twfth9/Morg_Grad_Cap/Grad/Hardware/Masters.png

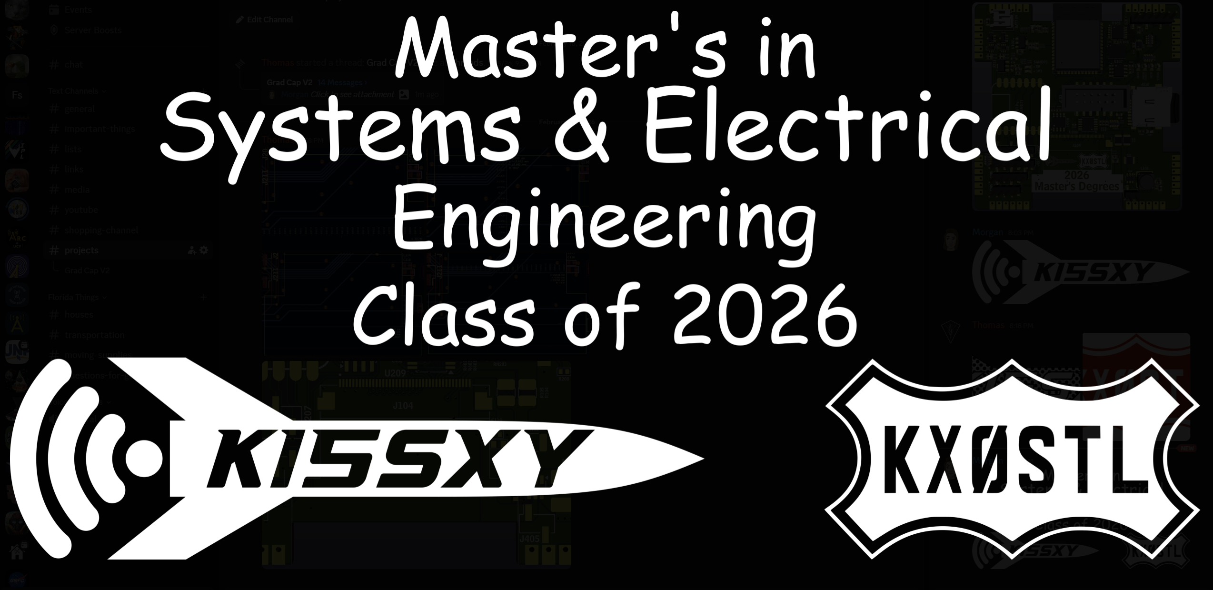
Grad/Hardware/Masters.png
