twfth9/Morg_Grad_Cap/Undergrad/Hardware/Images/morg_grad_cap.png

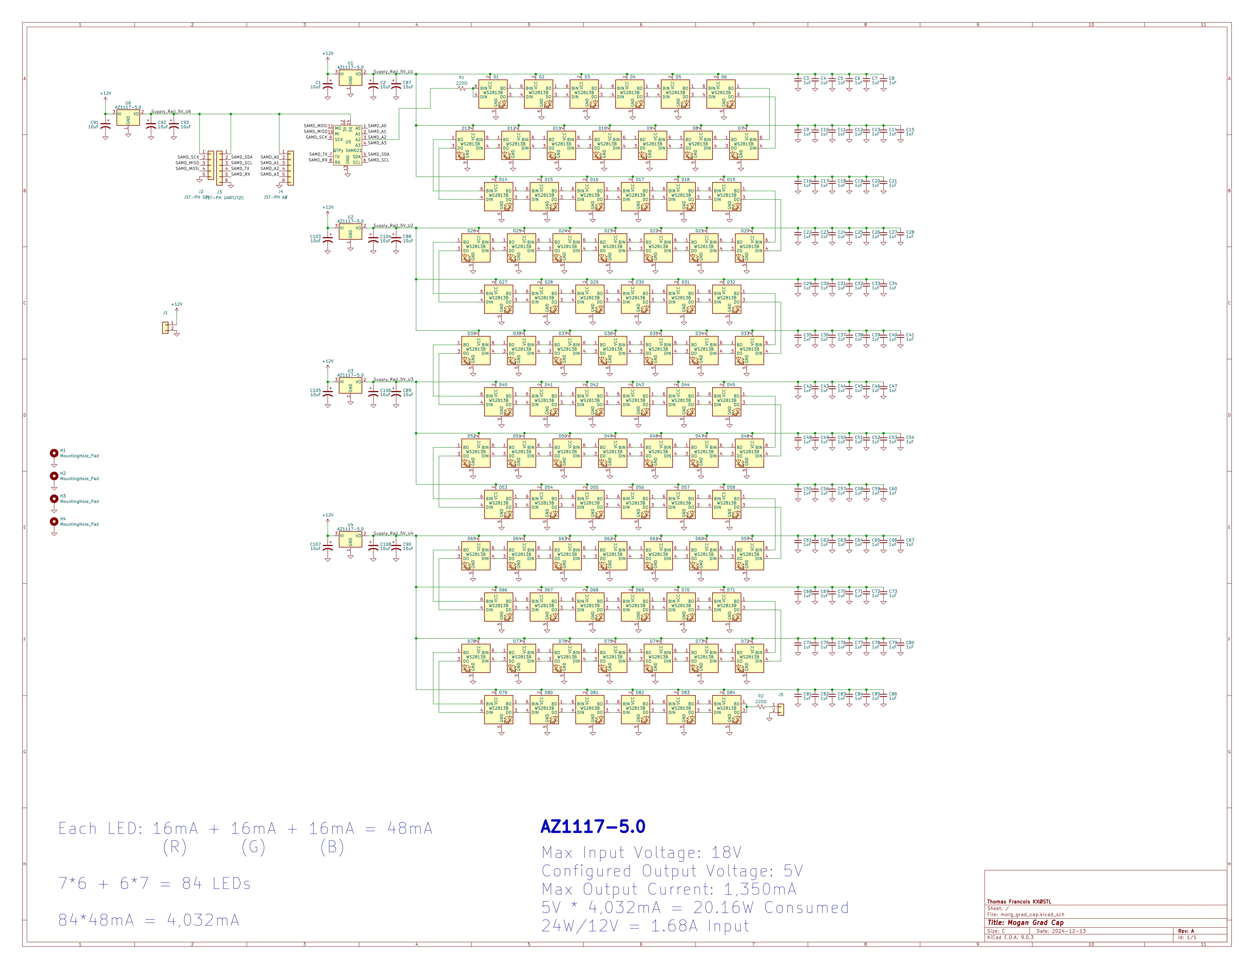
Undergrad/Hardware/Images/morg_grad_cap.png
