twfth9/Morg_Grad_Cap/Undergrad/Hardware/morg_grad_cap.kicad_pcb

## KiCad design Undergrad/Hardware/morg_grad_cap.kicad_pcb (2024-10-15)

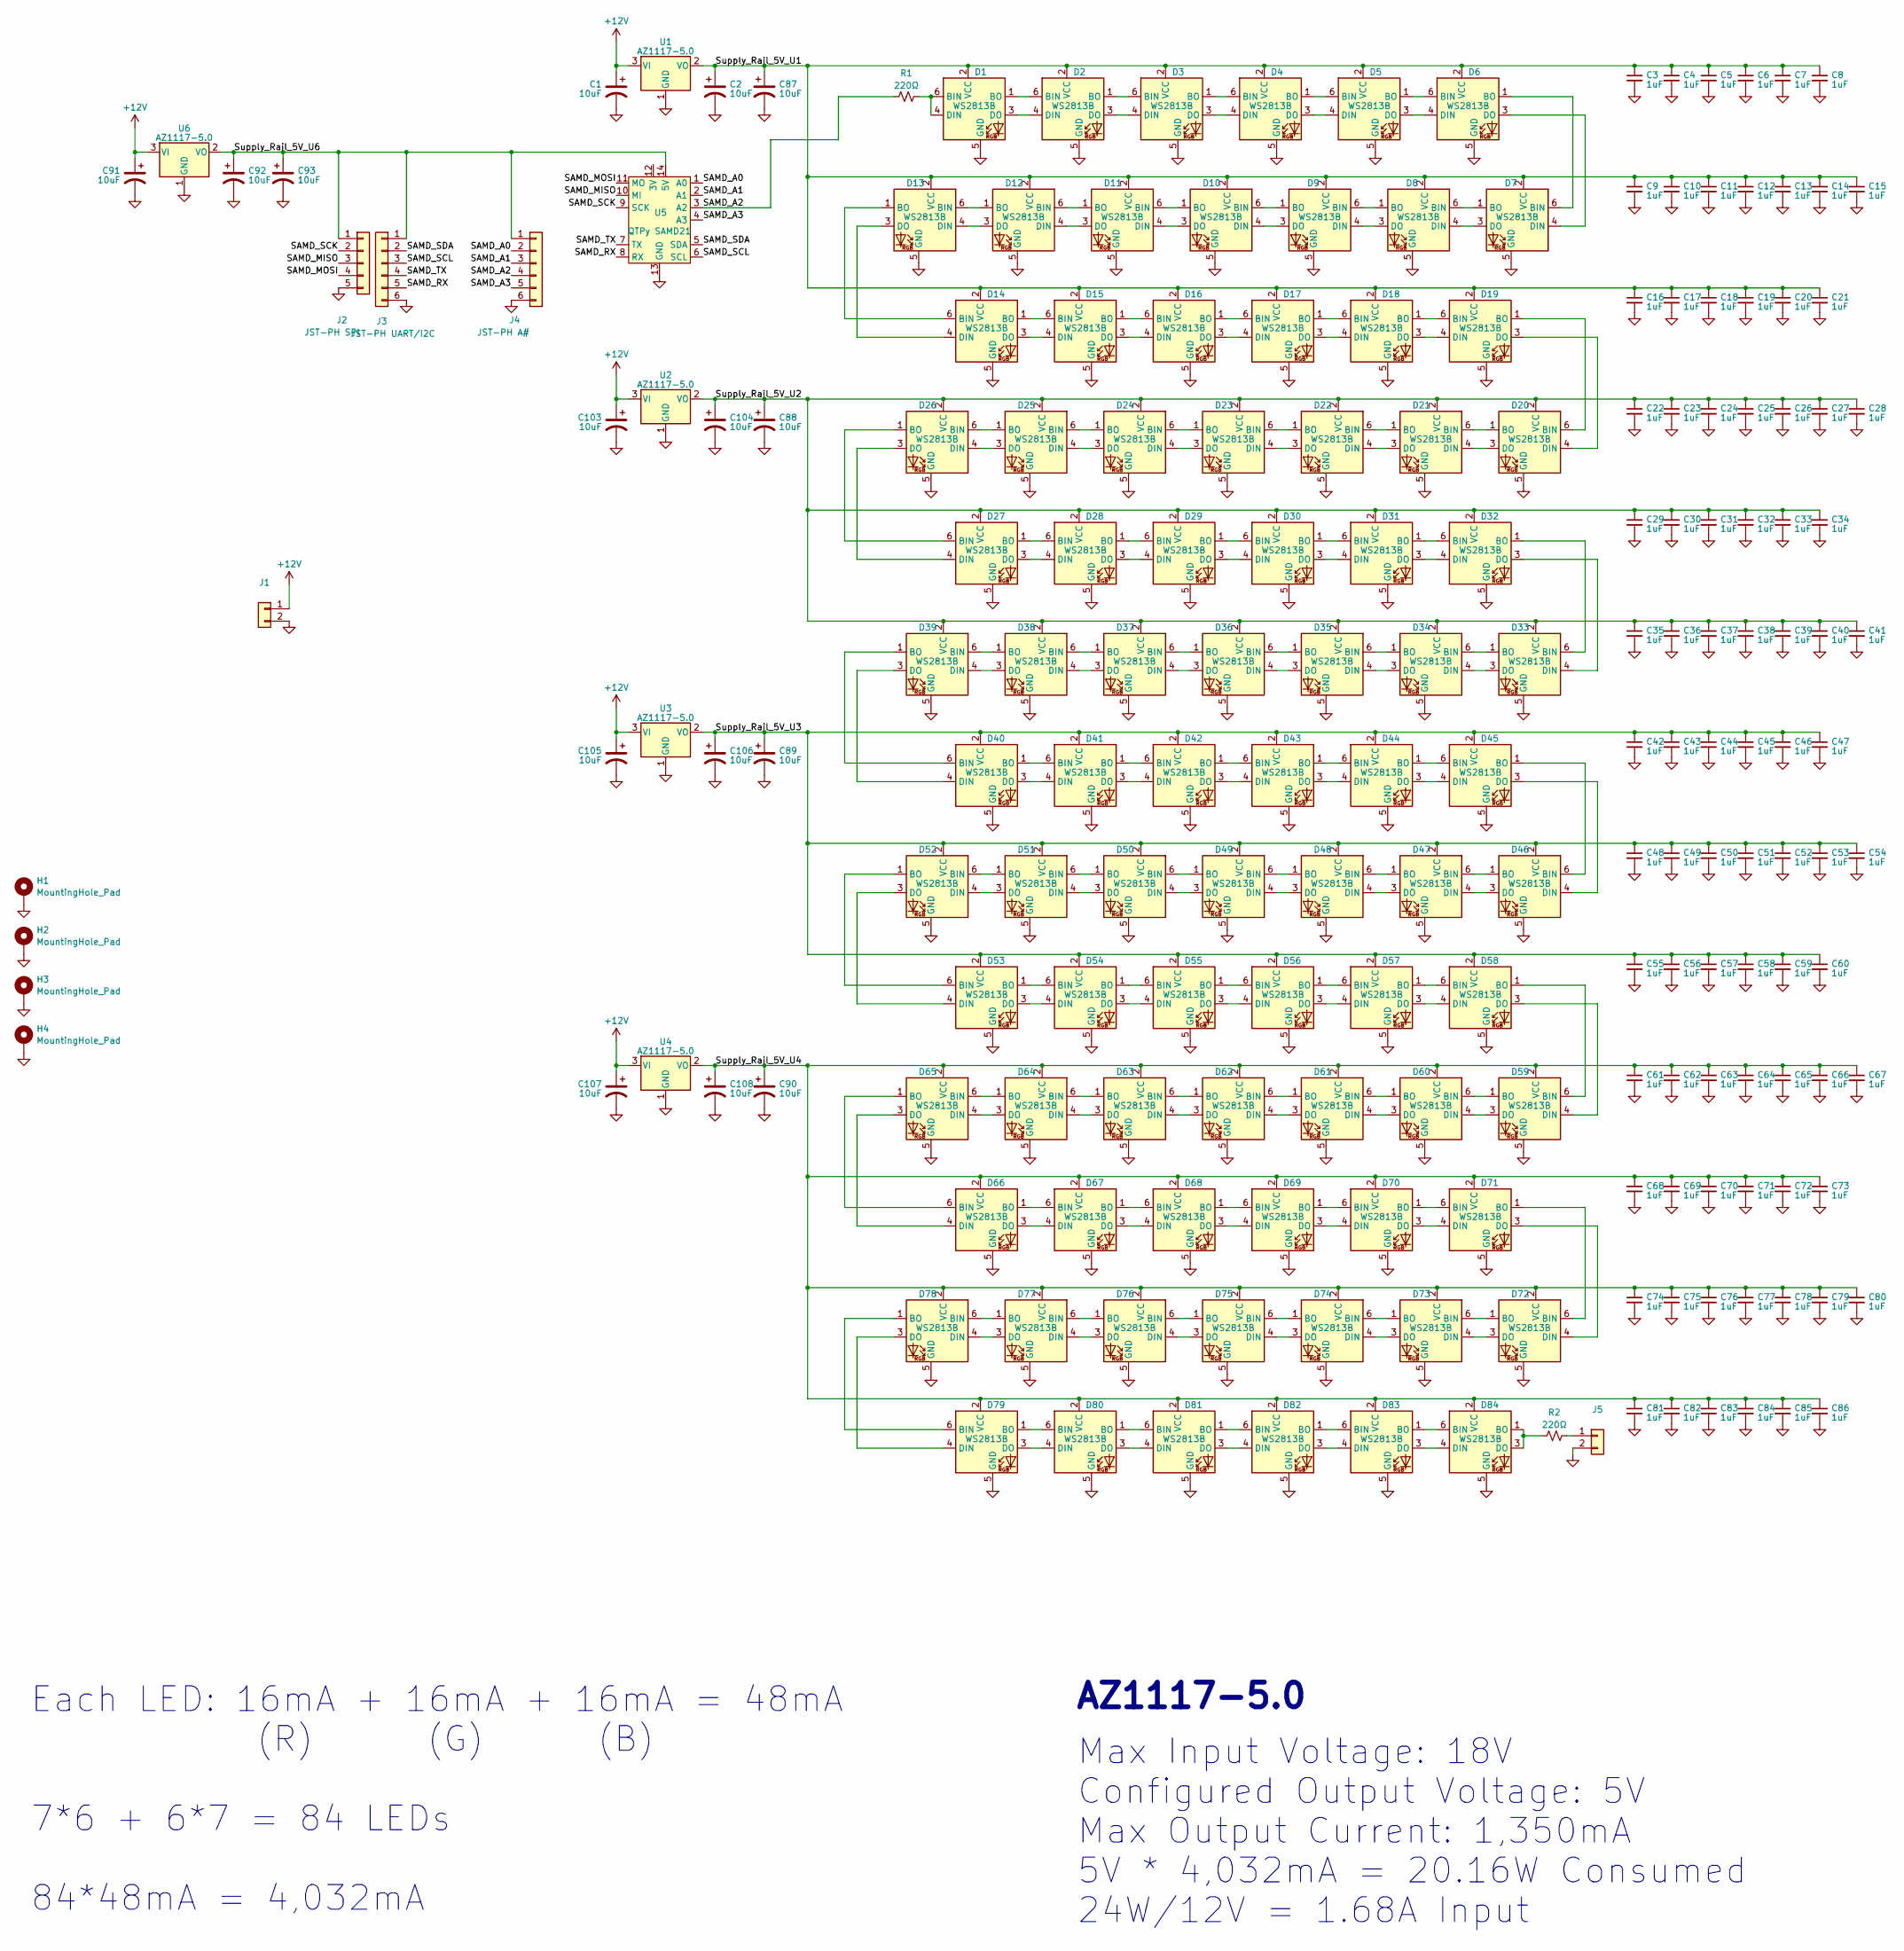
[picture p4: schematic morg_grad_cap.kicad_sch, Mogan Grad Cap]

Parts:
C1, C2, C87, C88, C89, C90, C91, C92, C93, C103, C104, C105, C106, C107, C108: 10uF; C_0805_2012Metric_Pad1.18x1.45mm_HandSolder
C3, C4, C5, C6, C7, C8, C9, C10, C11, C12, C13, C14, C15, C16, C17, C18, C19, C20, C21, C22, C23, C24, C25, C26, C27, C28, C29, C30, C31, C32, C33, C34, C35, C36, C37, C38, C39, C40, C41, C42, C43, C44, C45, C46, C47, C48, C49, C50, C51, C52, C53, C54, C55, C56, C57, C58, C59, C60, C61, C62, C63, C64, C65, C66, C67, C68, C69, C70, C71, C72, C73, C74, C75, C76, C77, C78, C79, C80, C81, C82, C83, C84, C85, C86: 1uF; C_0603_1608Metric_Pad1.08x0.95mm_HandSolder
D1, D2, D3, D4, D5, D6, D7, D8, D9, D10, D11, D12, D13, D14, D15, D16, D17, D18, D19, D20, D21, D22, D23, D24, D25, D26, D27, D28, D29, D30, D31, D32, D33, D34, D35, D36, D37, D38, D39, D40, D41, D42, D43, D44, D45, D46, D47, D48, D49, D50, D51, D52, D53, D54, D55, D56, D57, D58, D59, D60, D61, D62, D63, D64, D65, D66, D67, D68, D69, D70, D71, D72, D73, D74, D75, D76, D77, D78, D79, D80, D81, D82, D83, D84: WS2813B; LED_WS2812_PLCC6_5.0x5.0mm_P1.6mm
H1, H2, H3, H4: MountingHole_Pad; MountingHole_3.2mm_M3_Pad
J1: JST-PH Batt Power In; JST_PH_S2B-PH-K_1x02_P2.00mm_Horizontal
J2: JST-PH SPI; JST_PH_S5B-PH-K_1x05_P2.00mm_Horizontal
J3: JST-PH UART/I2C; JST_PH_S6B-PH-K_1x06_P2.00mm_Horizontal
J4: JST-PH A#; JST_PH_S6B-PH-K_1x06_P2.00mm_Horizontal
J5: Data Out; JST_PH_S2B-PH-K_1x02_P2.00mm_Horizontal
R1, R2: 220Ω; R_0603_1608Metric_Pad0.98x0.95mm_HandSolder
U1, U2, U3, U4, U6: AZ1117-5.0; SOT-223-3_TabPin2
U5: QTPy SAMD21; Py_QT_SAMD21

Connections:
+12V: C1.1, C91.1, C103.1, C105.1, C107.1, J1.1, U1.3 (VI), U2.3 (VI), U3.3 (VI), U4.3 (VI), U6.3 (VI)
/SAMD_A0: J4.2, U5.1 (A0)
/SAMD_A1: J4.3, U5.2 (A1)
/SAMD_A2: J4.4, R1.1, U5.3 (A2)
/SAMD_A3: J4.5, U5.4 (A3)
/SAMD_MISO: J2.3, U5.10 (MI)
/SAMD_MOSI: J2.4, U5.11 (MO)
/SAMD_RX: J3.5, U5.8 (RX)
/SAMD_SCK: J2.2, U5.9 (SCK)
/SAMD_SCL: J3.3, U5.6 (SCL)
/SAMD_SDA: J3.2, U5.5 (SDA)
/SAMD_TX: J3.4, U5.7 (TX)
/Supply_Rail_5V_U1: C2.1, C3.1, C4.1, C5.1, C6.1, C7.1, C8.1, C9.1, C10.1, C11.1, C12.1, C13.1, C14.1, C15.1, C16.1, C17.1, C18.1, C19.1, C20.1, C21.1, C87.1, D1.2 (VCC), D2.2 (VCC), D3.2 (VCC), D4.2 (VCC), D5.2 (VCC), D6.2 (VCC), D7.2 (VCC), D8.2 (VCC), D9.2 (VCC), D10.2 (VCC), D11.2 (VCC), D12.2 (VCC), D13.2 (VCC), D14.2 (VCC), D15.2 (VCC), D16.2 (VCC), D17.2 (VCC), D18.2 (VCC), D19.2 (VCC), U1.2 (VO)
/Supply_Rail_5V_U2: C22.1, C23.1, C24.1, C25.1, C26.1, C27.1, C28.1, C29.1, C30.1, C31.1, C32.1, C33.1, C34.1, C35.1, C36.1, C37.1, C38.1, C39.1, C40.1, C41.1, C88.1, C104.1, D20.2 (VCC), D21.2 (VCC), D22.2 (VCC), D23.2 (VCC), D24.2 (VCC), D25.2 (VCC), D26.2 (VCC), D27.2 (VCC), D28.2 (VCC), D29.2 (VCC), D30.2 (VCC), D31.2 (VCC), D32.2 (VCC), D33.2 (VCC), D34.2 (VCC), D35.2 (VCC), D36.2 (VCC), D37.2 (VCC), D38.2 (VCC), D39.2 (VCC), U2.2 (VO)
/Supply_Rail_5V_U3: C42.1, C43.1, C44.1, C45.1, C46.1, C47.1, C48.1, C49.1, C50.1, C51.1, C52.1, C53.1, C54.1, C55.1, C56.1, C57.1, C58.1, C59.1, C60.1, C89.1, C106.1, D40.2 (VCC), D41.2 (VCC), D42.2 (VCC), D43.2 (VCC), D44.2 (VCC), D45.2 (VCC), D46.2 (VCC), D47.2 (VCC), D48.2 (VCC), D49.2 (VCC), D50.2 (VCC), D51.2 (VCC), D52.2 (VCC), D53.2 (VCC), D54.2 (VCC), D55.2 (VCC), D56.2 (VCC), D57.2 (VCC), D58.2 (VCC), U3.2 (VO)
/Supply_Rail_5V_U4: C61.1, C62.1, C63.1, C64.1, C65.1, C66.1, C67.1, C68.1, C69.1, C70.1, C71.1, C72.1, C73.1, C74.1, C75.1, C76.1, C77.1, C78.1, C79.1, C80.1, C81.1, C82.1, C83.1, C84.1, C85.1, C86.1, C90.1, C108.1, D59.2 (VCC), D60.2 (VCC), D61.2 (VCC), D62.2 (VCC), D63.2 (VCC), D64.2 (VCC), D65.2 (VCC), D66.2 (VCC), D67.2 (VCC), D68.2 (VCC), D69.2 (VCC), D70.2 (VCC), D71.2 (VCC), D72.2 (VCC), D73.2 (VCC), D74.2 (VCC), D75.2 (VCC), D76.2 (VCC), D77.2 (VCC), D78.2 (VCC), D79.2 (VCC), D80.2 (VCC), D81.2 (VCC), D82.2 (VCC), D83.2 (VCC), D84.2 (VCC), U4.2 (VO)
/Supply_Rail_5V_U6: C92.1, C93.1, J2.1, J3.1, J4.1, U5.14 (5V), U6.2 (VO)
GND: C1.2, C2.2, C3.2, C4.2, C5.2, C6.2, C7.2, C8.2, C9.2, C10.2, C11.2, C12.2, C13.2, C14.2, C15.2, C16.2, C17.2, C18.2, C19.2, C20.2, C21.2, C22.2, C23.2, C24.2, C25.2, C26.2, C27.2, C28.2, C29.2, C30.2, C31.2, C32.2, C33.2, C34.2, C35.2, C36.2, C37.2, C38.2, C39.2, C40.2, C41.2, C42.2, C43.2, C44.2, C45.2, C46.2, C47.2, C48.2, C49.2, C50.2, C51.2, C52.2, C53.2, C54.2, C55.2, C56.2, C57.2, C58.2, C59.2, C60.2, C61.2, C62.2, C63.2, C64.2, C65.2, C66.2, C67.2, C68.2, C69.2, C70.2, C71.2, C72.2, C73.2, C74.2, C75.2, C76.2, C77.2, C78.2, C79.2, C80.2, C81.2, C82.2, C83.2, C84.2, C85.2, C86.2, C87.2, C88.2, C89.2, C90.2, C91.2, C92.2, C93.2, C103.2, C104.2, C105.2, C106.2, C107.2, C108.2, D1.5 (GND), D2.5 (GND), D3.5 (GND), D4.5 (GND), D5.5 (GND), D6.5 (GND), D7.5 (GND), D8.5 (GND), D9.5 (GND), D10.5 (GND), D11.5 (GND), D12.5 (GND), D13.5 (GND), D14.5 (GND), D15.5 (GND), D16.5 (GND), D17.5 (GND), D18.5 (GND), D19.5 (GND), D20.5 (GND), D21.5 (GND), D22.5 (GND), D23.5 (GND), D24.5 (GND), D25.5 (GND), D26.5 (GND), D27.5 (GND), D28.5 (GND), D29.5 (GND), D30.5 (GND), D31.5 (GND), D32.5 (GND), D33.5 (GND), D34.5 (GND), D35.5 (GND), D36.5 (GND), D37.5 (GND), D38.5 (GND), D39.5 (GND), D40.5 (GND), D41.5 (GND), D42.5 (GND), D43.5 (GND), D44.5 (GND), D45.5 (GND), D46.5 (GND), D47.5 (GND), D48.5 (GND), D49.5 (GND), D50.5 (GND), D51.5 (GND), D52.5 (GND), D53.5 (GND), D54.5 (GND), D55.5 (GND), D56.5 (GND), D57.5 (GND), D58.5 (GND), D59.5 (GND), D60.5 (GND), D61.5 (GND), D62.5 (GND), D63.5 (GND), D64.5 (GND), D65.5 (GND), D66.5 (GND), D67.5 (GND), D68.5 (GND), D69.5 (GND), D70.5 (GND), D71.5 (GND), D72.5 (GND), D73.5 (GND), D74.5 (GND), D75.5 (GND), D76.5 (GND), D77.5 (GND), D78.5 (GND), D79.5 (GND), D80.5 (GND), D81.5 (GND), D82.5 (GND), D83.5 (GND), D84.5 (GND), H1.1, H2.1, H3.1, H4.1, J1.2, J2.5, J3.6, J4.6, J5.2, U1.1 (GND), U2.1 (GND), U3.1 (GND), U4.1 (GND), U5.13 (GND), U6.1 (GND)
unnamed: D1.4 (DIN), D1.6 (BIN), R1.2
unnamed: D1.1 (BO), D2.6 (BIN)
unnamed: D1.3 (DO), D2.4 (DIN)
unnamed: D2.1 (BO), D3.6 (BIN)
unnamed: D2.3 (DO), D3.4 (DIN)
unnamed: D3.1 (BO), D4.6 (BIN)
unnamed: D3.3 (DO), D4.4 (DIN)
unnamed: D4.1 (BO), D5.6 (BIN)
unnamed: D4.3 (DO), D5.4 (DIN)
unnamed: D5.1 (BO), D6.6 (BIN)
unnamed: D5.3 (DO), D6.4 (DIN)
unnamed: D6.1 (BO), D7.6 (BIN)
unnamed: D6.3 (DO), D7.4 (DIN)
unnamed: D7.1 (BO), D8.6 (BIN)
unnamed: D7.3 (DO), D8.4 (DIN)
unnamed: D8.1 (BO), D9.6 (BIN)
unnamed: D8.3 (DO), D9.4 (DIN)
unnamed: D9.1 (BO), D10.6 (BIN)
unnamed: D10.1 (BO), D11.6 (BIN)
unnamed: D9.3 (DO), D10.4 (DIN)
unnamed: D10.3 (DO), D11.4 (DIN)
unnamed: D11.1 (BO), D12.6 (BIN)
unnamed: D11.3 (DO), D12.4 (DIN)
unnamed: D12.1 (BO), D13.6 (BIN)
unnamed: D12.3 (DO), D13.4 (DIN)
unnamed: D13.1 (BO), D14.6 (BIN)
unnamed: D13.3 (DO), D14.4 (DIN)
unnamed: D14.1 (BO), D15.6 (BIN)
unnamed: D14.3 (DO), D15.4 (DIN)
unnamed: D15.1 (BO), D16.6 (BIN)
unnamed: D15.3 (DO), D16.4 (DIN)
unnamed: D16.1 (BO), D17.6 (BIN)
unnamed: D16.3 (DO), D17.4 (DIN)
unnamed: D17.1 (BO), D18.6 (BIN)
unnamed: D17.3 (DO), D18.4 (DIN)
unnamed: D18.1 (BO), D19.6 (BIN)
unnamed: D18.3 (DO), D19.4 (DIN)
unnamed: D19.1 (BO), D20.6 (BIN)
unnamed: D19.3 (DO), D20.4 (DIN)
unnamed: D20.1 (BO), D21.6 (BIN)
unnamed: D20.3 (DO), D21.4 (DIN)
unnamed: D21.1 (BO), D22.6 (BIN)
unnamed: D21.3 (DO), D22.4 (DIN)
unnamed: D22.1 (BO), D23.6 (BIN)
unnamed: D22.3 (DO), D23.4 (DIN)
unnamed: D23.1 (BO), D24.6 (BIN)
unnamed: D23.3 (DO), D24.4 (DIN)
unnamed: D24.1 (BO), D25.6 (BIN)
unnamed: D24.3 (DO), D25.4 (DIN)
unnamed: D25.1 (BO), D26.6 (BIN)
unnamed: D25.3 (DO), D26.4 (DIN)
unnamed: D26.1 (BO), D27.6 (BIN)
unnamed: D26.3 (DO), D27.4 (DIN)
unnamed: D27.1 (BO), D28.6 (BIN)
unnamed: D27.3 (DO), D28.4 (DIN)
unnamed: D28.1 (BO), D29.6 (BIN)
unnamed: D28.3 (DO), D29.4 (DIN)
unnamed: D29.1 (BO), D30.6 (BIN)
unnamed: D29.3 (DO), D30.4 (DIN)
unnamed: D30.1 (BO), D31.6 (BIN)
unnamed: D30.3 (DO), D31.4 (DIN)
unnamed: D31.1 (BO), D32.6 (BIN)
unnamed: D31.3 (DO), D32.4 (DIN)
unnamed: D32.1 (BO), D33.6 (BIN)
unnamed: D32.3 (DO), D33.4 (DIN)
unnamed: D33.1 (BO), D34.6 (BIN)
unnamed: D33.3 (DO), D34.4 (DIN)
unnamed: D34.1 (BO), D35.6 (BIN)
unnamed: D34.3 (DO), D35.4 (DIN)
unnamed: D35.1 (BO), D36.6 (BIN)
unnamed: D35.3 (DO), D36.4 (DIN)
unnamed: D36.1 (BO), D37.6 (BIN)
unnamed: D36.3 (DO), D37.4 (DIN)
unnamed: D37.1 (BO), D38.6 (BIN)
unnamed: D37.3 (DO), D38.4 (DIN)
unnamed: D38.1 (BO), D39.6 (BIN)
unnamed: D38.3 (DO), D39.4 (DIN)
unnamed: D39.1 (BO), D40.6 (BIN)
unnamed: D39.3 (DO), D40.4 (DIN)
unnamed: D40.1 (BO), D41.6 (BIN)
unnamed: D40.3 (DO), D41.4 (DIN)
unnamed: D41.1 (BO), D42.6 (BIN)
unnamed: D41.3 (DO), D42.4 (DIN)
unnamed: D42.1 (BO), D43.6 (BIN)
unnamed: D42.3 (DO), D43.4 (DIN)
unnamed: D43.1 (BO), D44.6 (BIN)
unnamed: D43.3 (DO), D44.4 (DIN)
unnamed: D44.1 (BO), D45.6 (BIN)
unnamed: D44.3 (DO), D45.4 (DIN)
unnamed: D45.1 (BO), D46.6 (BIN)
unnamed: D45.3 (DO), D46.4 (DIN)
unnamed: D46.1 (BO), D47.6 (BIN)
unnamed: D46.3 (DO), D47.4 (DIN)
unnamed: D47.1 (BO), D48.6 (BIN)
unnamed: D47.3 (DO), D48.4 (DIN)
unnamed: D48.1 (BO), D49.6 (BIN)
unnamed: D48.3 (DO), D49.4 (DIN)
unnamed: D49.1 (BO), D50.6 (BIN)
unnamed: D49.3 (DO), D50.4 (DIN)
unnamed: D50.1 (BO), D51.6 (BIN)
unnamed: D50.3 (DO), D51.4 (DIN)
unnamed: D51.1 (BO), D52.6 (BIN)
unnamed: D51.3 (DO), D52.4 (DIN)
unnamed: D52.1 (BO), D53.6 (BIN)
unnamed: D52.3 (DO), D53.4 (DIN)
unnamed: D53.1 (BO), D54.6 (BIN)
unnamed: D53.3 (DO), D54.4 (DIN)
unnamed: D54.1 (BO), D55.6 (BIN)
unnamed: D54.3 (DO), D55.4 (DIN)
unnamed: D55.1 (BO), D56.6 (BIN)
unnamed: D55.3 (DO), D56.4 (DIN)
unnamed: D56.1 (BO), D57.6 (BIN)
unnamed: D56.3 (DO), D57.4 (DIN)
unnamed: D57.1 (BO), D58.6 (BIN)
unnamed: D57.3 (DO), D58.4 (DIN)
unnamed: D58.1 (BO), D59.6 (BIN)
unnamed: D58.3 (DO), D59.4 (DIN)
unnamed: D59.1 (BO), D60.6 (BIN)
unnamed: D59.3 (DO), D60.4 (DIN)
unnamed: D60.1 (BO), D61.6 (BIN)
unnamed: D60.3 (DO), D61.4 (DIN)
unnamed: D61.1 (BO), D62.6 (BIN)
unnamed: D61.3 (DO), D62.4 (DIN)
unnamed: D62.1 (BO), D63.6 (BIN)
unnamed: D62.3 (DO), D63.4 (DIN)
unnamed: D63.1 (BO), D64.6 (BIN)
unnamed: D63.3 (DO), D64.4 (DIN)
unnamed: D64.1 (BO), D65.6 (BIN)
unnamed: D64.3 (DO), D65.4 (DIN)
unnamed: D65.1 (BO), D66.6 (BIN)
unnamed: D65.3 (DO), D66.4 (DIN)
unnamed: D66.1 (BO), D67.6 (BIN)
unnamed: D66.3 (DO), D67.4 (DIN)
unnamed: D67.1 (BO), D68.6 (BIN)
unnamed: D67.3 (DO), D68.4 (DIN)
unnamed: D68.1 (BO), D69.6 (BIN)
unnamed: D68.3 (DO), D69.4 (DIN)
unnamed: D69.1 (BO), D70.6 (BIN)
unnamed: D69.3 (DO), D70.4 (DIN)
unnamed: D70.1 (BO), D71.6 (BIN)
unnamed: D70.3 (DO), D71.4 (DIN)
unnamed: D71.1 (BO), D72.6 (BIN)
unnamed: D71.3 (DO), D72.4 (DIN)
unnamed: D72.1 (BO), D73.6 (BIN)
unnamed: D72.3 (DO), D73.4 (DIN)
unnamed: D73.1 (BO), D74.6 (BIN)
unnamed: D73.3 (DO), D74.4 (DIN)
unnamed: D74.1 (BO), D75.6 (BIN)
unnamed: D74.3 (DO), D75.4 (DIN)
unnamed: D75.1 (BO), D76.6 (BIN)
unnamed: D75.3 (DO), D76.4 (DIN)
unnamed: D76.1 (BO), D77.6 (BIN)
unnamed: D76.3 (DO), D77.4 (DIN)
unnamed: D77.1 (BO), D78.6 (BIN)
unnamed: D77.3 (DO), D78.4 (DIN)
unnamed: D78.1 (BO), D79.6 (BIN)
unnamed: D78.3 (DO), D79.4 (DIN)
unnamed: D79.1 (BO), D80.6 (BIN)
unnamed: D79.3 (DO), D80.4 (DIN)
unnamed: D80.1 (BO), D81.6 (BIN)
unnamed: D80.3 (DO), D81.4 (DIN)
unnamed: D81.1 (BO), D82.6 (BIN)
unnamed: D81.3 (DO), D82.4 (DIN)
unnamed: D82.1 (BO), D83.6 (BIN)
unnamed: D82.3 (DO), D83.4 (DIN)
unnamed: D83.1 (BO), D84.6 (BIN)
unnamed: D83.3 (DO), D84.4 (DIN)
unnamed: D84.1 (BO), D84.3 (DO), R2.1
unnamed: J5.1, R2.2

Notes on the sheet:
Each LED: 16mA + 16mA + 16mA = 48mA (R) (G) (B) 7*6 + 6*7 = 84 LEDs 84*48mA = 4,032mA
Max Input Voltage: 18V Configured Output Voltage: 5V Max Output Current: 1,350mA 5V * 4,032mA = 20.16W Consumed 24W/12V = 1.68A Input
AZ1117-5.0

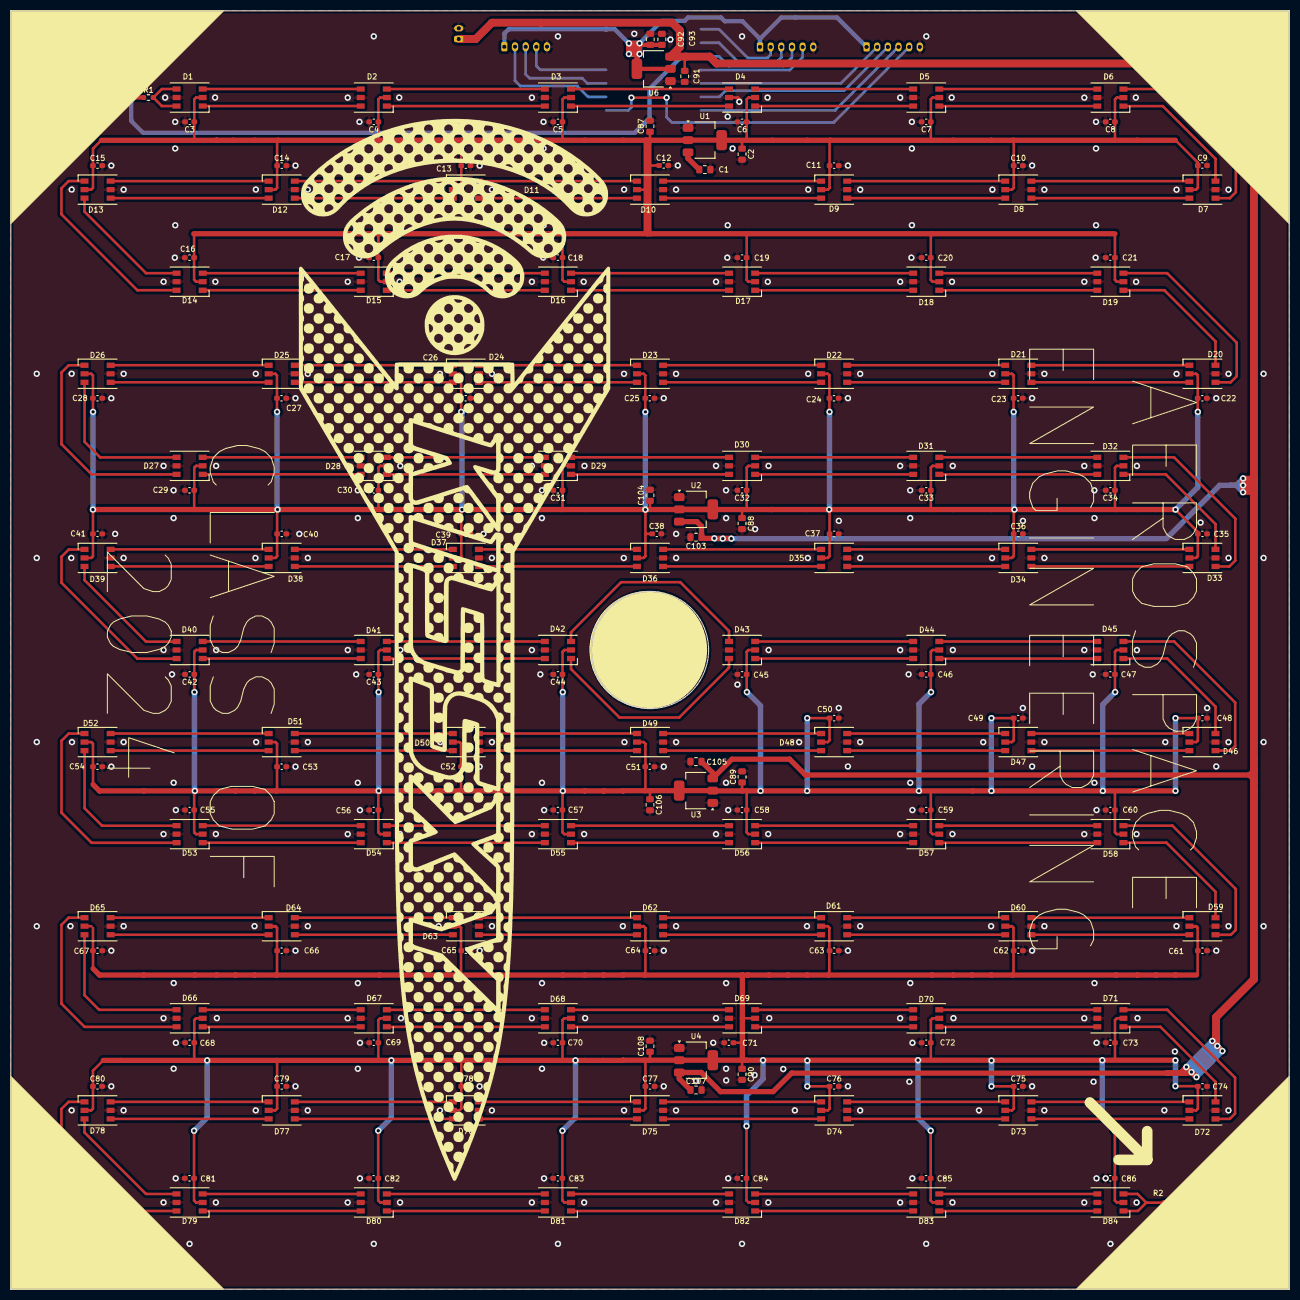
[picture p5: board morg_grad_cap.kicad_pcb from above]

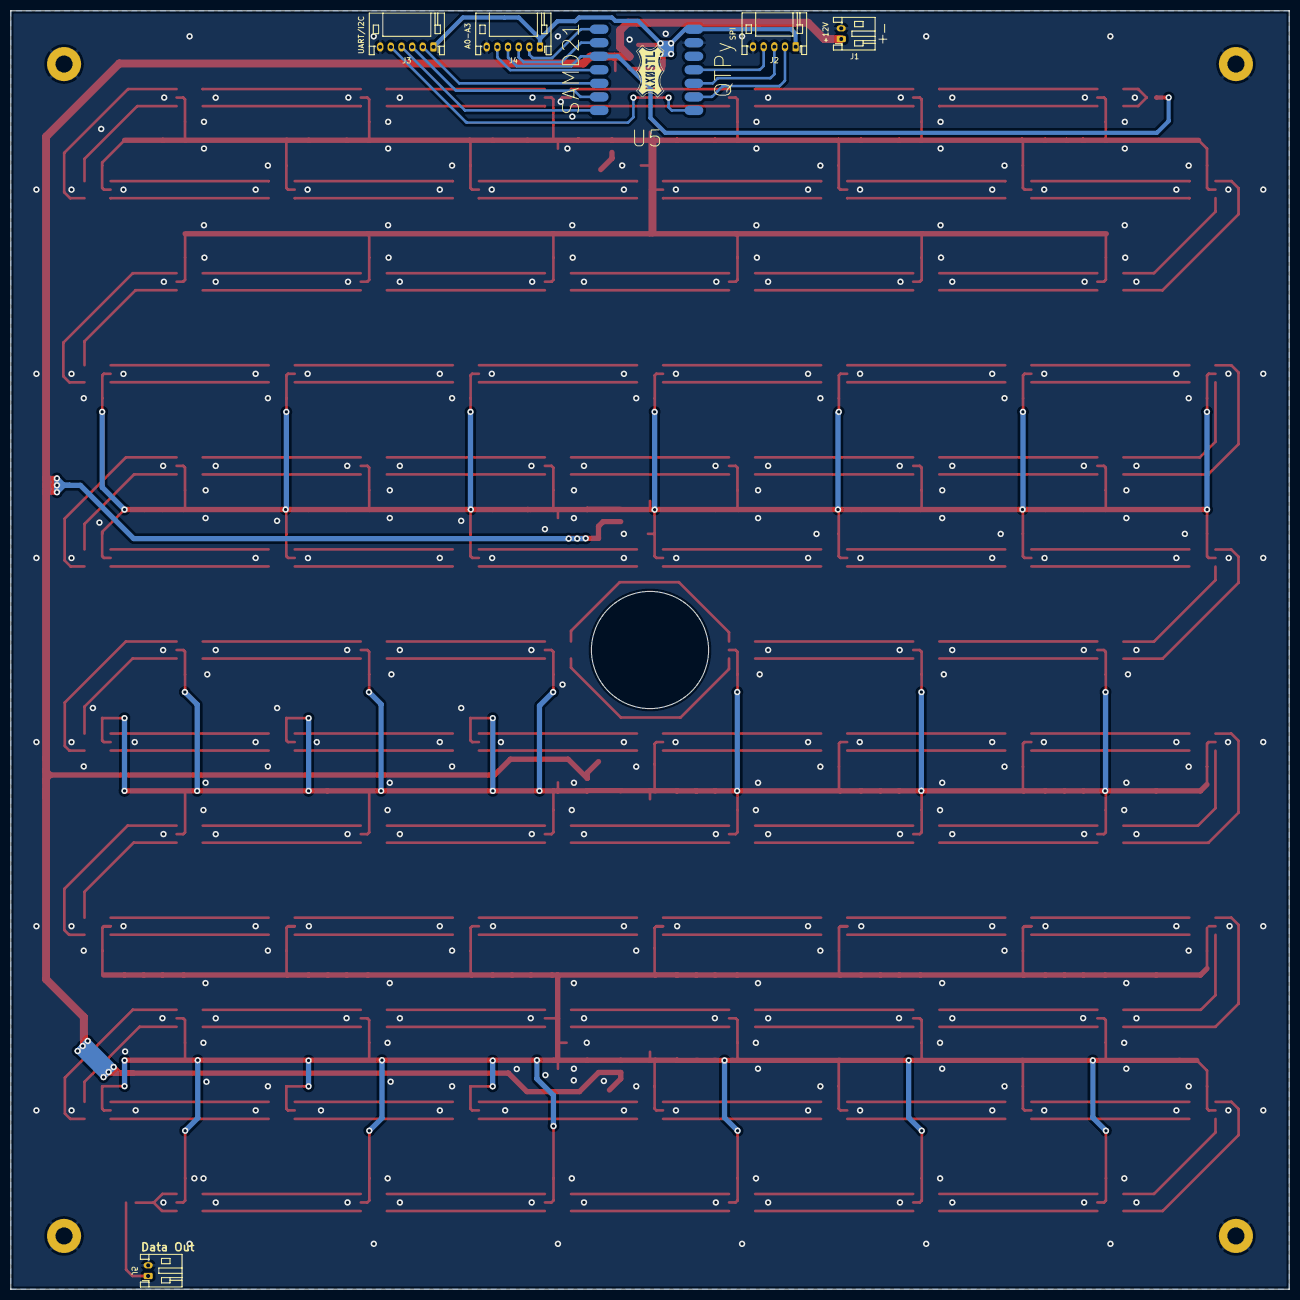
[picture p6: board morg_grad_cap.kicad_pcb from below]

Board: 2 copper layers, 240.0 x 240.0 mm, 200 parts (6 on the bottom side), 187 nets.
