twfth9/Morg_Grad_Cap/Grad/Hardware/grad_cap_display.kicad_pcb

## KiCad design Grad/Hardware/grad_cap_display.kicad_pcb (2026-02-20)

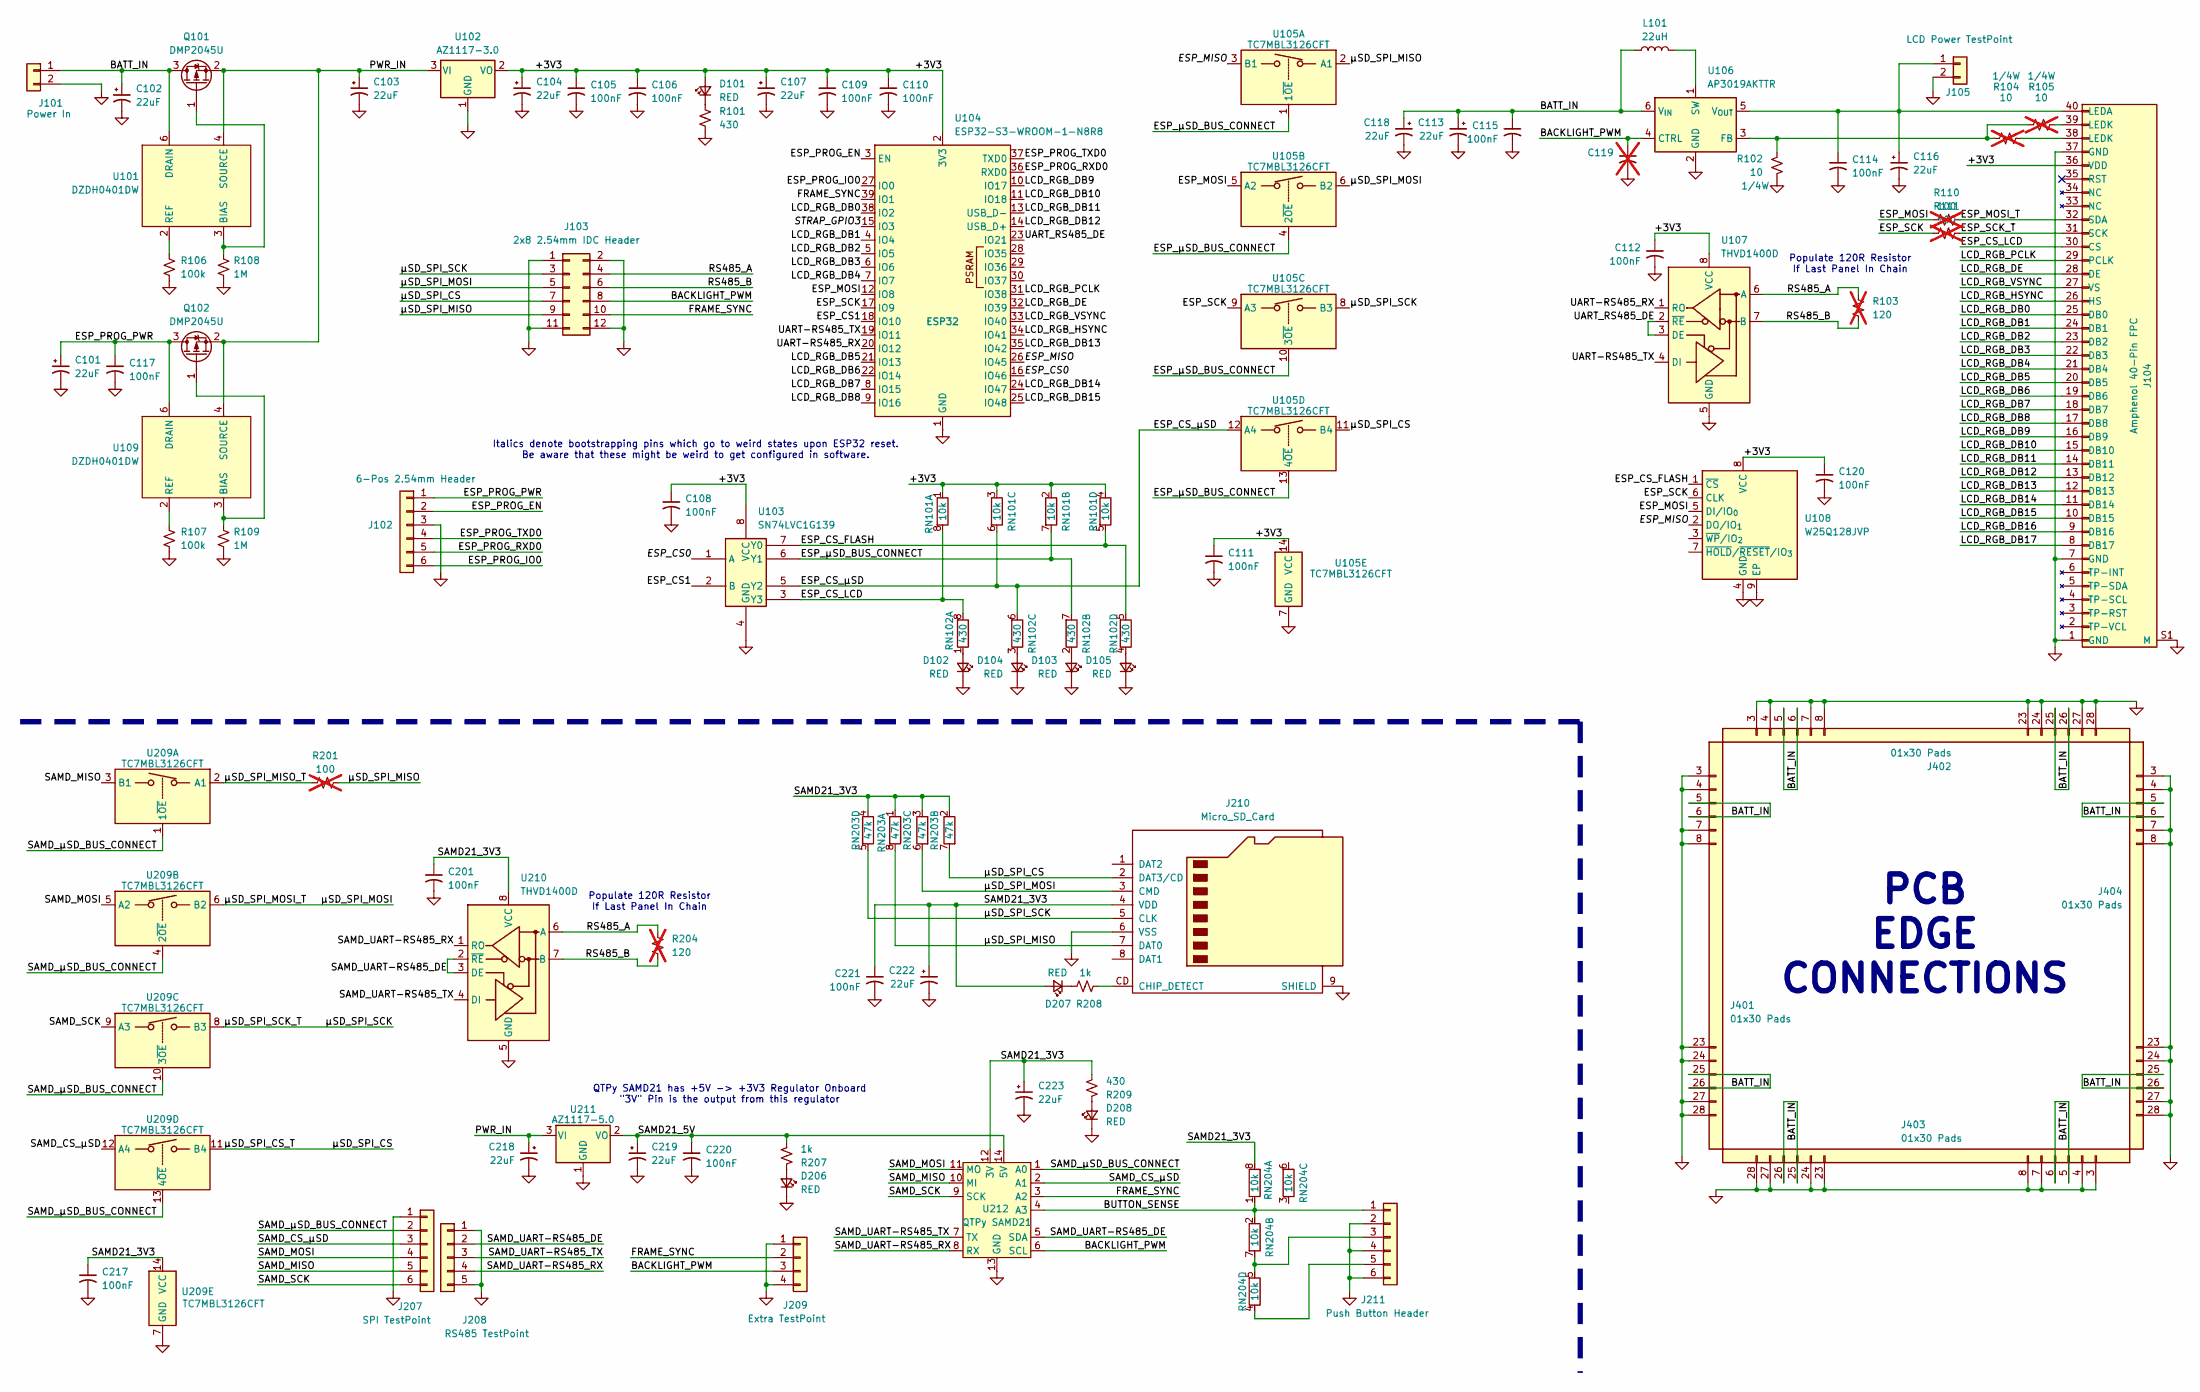
[picture p7: schematic grad_cap_display.kicad_sch]

Parts:
C101, C102, C103, C104, C107, C113, C116, C118, C218, C219, C222, C223: 22uF; Worthington_C_0603
C105, C106, C108, C109, C110, C111, C112, C114, C115, C117, C120, C201, C217, C220, C221: 100nF; Worthington_C_0402
C119: Worthington_C_0402; not fitted
D101, D102, D103, D104, D105, D206, D207, D208: RED; Worthington_LED_0603
J101: Power In; JST_PH_S2B-PH-K_1x02_P2.00mm_Horizontal
J102: 6-Pos 2.54mm Header; PinHeader_1x06_P2.54mm_Vertical_SMD_Pin1Left
J103: 2x8 2.54mm IDC Header; IDC-Header_2x06_P2.54mm_Vertical_SMD
J104: Amphenol 40-Pin FPC; AMPHENOL_62684-402100ALF; DigiKey Part 62684-402100ALF
J105: LCD Power TestPoint; PinHeader_1x02_P2.54mm_Vertical_SMD_Pin1Right
J207: SPI TestPoint; PinHeader_1x06_P2.54mm_Vertical_SMD_Pin1Right
J208: RS485 TestPoint; PinHeader_1x05_P2.54mm_Vertical_SMD_Pin1Right
J209: Extra TestPoint; PinHeader_1x04_P2.54mm_Vertical_SMD_Pin1Right
J210: Micro_SD_Card; CUI_MSD-4-A; DigiKey Part 2223-MSD-4-ACT-ND
J211: Push Button Header; PinHeader_1x06_P2.54mm_Vertical_SMD_Pin1Right
J401, J402, J403, J404: 01x30 Pads; PinSocket_1x30_P2.54mm_Vertical
L101: 22uH; CDRH5D28
Q101, Q102: DMP2045U; SOT-23
R101, R209: 430; Worthington_R_0402
R102: 10; R_1210_3225Metric
R103, R204: 120; Worthington_R_0402; not fitted
R104, R105: 10; R_1210_3225Metric; not fitted
R106, R107: 100k; Worthington_R_0402
R108, R109: 1M; Worthington_R_0402
R110, R111, R201: 100; Worthington_R_0402; not fitted
R207, R208: 1k; Worthington_R_0402
RN101, RN204: 10k; RESCAXE80P320X160X70-8N; DigiKey Part CAY16-1002F4LFCT-ND
RN102: 430; RESCAXE80P320X160X70-8N; DigiKey Part 13-YC164-JR-07430RLCT-ND
RN203: 47k; RESCAXE80P320X160X70-8N; DigiKey Part CAT16-4702F4LFCT-ND
U101, U109: DZDH0401DW; SOT-363_SC-70-6
U102: AZ1117-3.0; SOT-89-3
U103: SN74LVC1G139; VSSOP-8_2.3x2mm_P0.5mm; DigiKey Part 296-18203-1-ND
U104: ESP32-S3-WROOM-1-N8R8; ESP32-S3-WROOM-1; DigiKey Part 5407-ESP32-S3-WROOM-1-N8R8CT-ND
U105: TC7MBL3126CFT; TSSOP-14_4.4x5mm_P0.65mm; DigiKey Part 264-TC7MBL3126CFT(EL)CT-ND
U106: AP3019AKTTR; TSOT-23-6; DigiKey Part Number AP3019AKTR-G1
U107: THVD1400D; SOIC-8_3.9x4.9mm_P1.27mm; DigiKey Part 296-THVD1400DRCT-ND
U108: W25Q128JVP; WSON-8-1EP_6x5mm_P1.27mm_EP3.4x4.3mm; DigiKey Part 256-W25Q128JVPIQ-TUBE-ND
U209: TC7MBL3126CFT; TSSOP-14_4.4x5mm_P0.65mm
U210: THVD1400D; SOIC-8_3.9x4.9mm_P1.27mm
U211: AZ1117-5.0; SOT-89-3
U212: QTPy SAMD21; Py_QT_SAMD21

Connections:
/+3V3: C104.1, C105.1, C106.1, C107.1, C108.1, C109.1, C110.1, C111.1, C112.1, C120.1, D101.2 (A), J104.36 (VDD), RN101.1 (4), RN101.2, RN101.3, RN101.4, U102.2 (VO), U103.8 (VCC), U104.2 (3V3), U105.14 (VCC), U107.8 (VCC), U108.8 (VCC)
/BACKLIGHT_PWM: C119.1, J103.8, J209.3, U106.4 (CTRL), U212.6 (SCL)
/BATT_IN: C102.1, C113.1, C115.1, C118.1, J101.1, J401.5, J401.6, J401.25, J401.26, J402.5, J402.6, J402.25, J402.26, J403.5, J403.6, J403.25, J403.26, J404.5, J404.6, J404.25, J404.26, L101.1, Q101.3 (D), U101.6 (DRAIN), U106.6 (V_{IN})
/BUTTON_SENSE: J211.1, RN204.1 (4), RN204.2, U212.4 (A3)
/ESP_CS0: U103.1 (A), U104.16 (IO46)
/ESP_CS1: U103.2 (B), U104.18 (IO10)
/ESP_CS_FLASH: RN101.5, RN102.5, U103.7 (Y0), U108.1 (~CS)
/ESP_CS_LCD: J104.30 (CS), RN101.8, RN102.8, U103.3 (Y3)
/ESP_CS_µSD: RN101.6, RN102.6, U103.5 (Y2), U105.12 (A4)
/ESP_MISO: U104.26 (IO45), U105.3 (B1), U108.2 (DO/IO_{1})
/ESP_MOSI: R110.1, U104.12 (IO8), U105.5 (A2), U108.5 (DI/IO_{0})
/ESP_MOSI_T: J104.32 (SDA), R110.2
/ESP_PROG_EN: J102.2, U104.3 (EN)
/ESP_PROG_IO0: J102.6, U104.27 (IO0)
/ESP_PROG_PWR: C101.1, C117.1, J102.1, Q102.3 (D), U109.6 (DRAIN)
/ESP_PROG_RXD0: J102.5, U104.36 (RXD0)
/ESP_PROG_TXD0: J102.4, U104.37 (TXD0)
/ESP_SCK: R111.1, U104.17 (IO9), U105.9 (A3), U108.6 (CLK)
/ESP_SCK_T: J104.31 (SCK), R111.2
/ESP_µSD_BUS_CONNECT: RN101.7 (5), RN102.7 (5), U103.6 (Y1), U105.1 (1~OE), U105.4 (2~OE), U105.10 (3~OE), U105.13 (4~OE)
/FRAME_SYNC: J103.10, J209.2, U104.39 (IO1), U212.3 (A2)
/LCD_RGB_DB0: J104.25 (DB0), U104.38 (IO2)
/LCD_RGB_DB1: J104.24 (DB1), U104.4 (IO4)
/LCD_RGB_DB2: J104.23 (DB2), U104.5 (IO5)
/LCD_RGB_DB3: J104.22 (DB3), U104.6 (IO6)
/LCD_RGB_DB4: J104.21 (DB4), U104.7 (IO7)
/LCD_RGB_DB5: J104.20 (DB5), U104.21 (IO13)
/LCD_RGB_DB6: J104.19 (DB6), U104.22 (IO14)
/LCD_RGB_DB7: J104.18 (DB7), U104.8 (IO15)
/LCD_RGB_DB8: J104.17 (DB8), U104.9 (IO16)
/LCD_RGB_DB9: J104.16 (DB9), U104.10 (IO17)
/LCD_RGB_DB10: J104.15 (DB10), U104.11 (IO18)
/LCD_RGB_DB11: J104.14 (DB11), U104.13 (USB_D-)
/LCD_RGB_DB12: J104.13 (DB12), U104.14 (USB_D+)
/LCD_RGB_DB13: J104.12 (DB13), U104.35 (IO42)
/LCD_RGB_DB14: J104.11 (DB14), U104.24 (IO47)
/LCD_RGB_DB15: J104.10 (DB15), U104.25 (IO48)
/LCD_RGB_DB16: J104.9 (DB16)
/LCD_RGB_DB17: J104.8 (DB17)
/LCD_RGB_DE: J104.28 (DE), U104.32 (IO39)
/LCD_RGB_HSYNC: J104.26 (HS), U104.34 (IO41)
/LCD_RGB_PCLK: J104.29 (PCLK), U104.31 (IO38)
/LCD_RGB_VSYNC: J104.27 (VS), U104.33 (IO40)
/PWR_IN: C103.1, C218.1, Q101.2 (S), Q102.2 (S), U101.4 (SOURCE), U102.3 (VI), U109.4 (SOURCE), U211.3 (VI)
/RS485_A: J103.4, R103.1, R204.1, U107.6 (A), U210.6 (A)
/RS485_B: J103.6, R103.2, R204.2, U107.7 (B), U210.7 (B)
/SAMD21_3V3: C201.1, C217.1, C221.1, C222.1, C223.1, D207.2 (A), J210.4 (VDD), R209.2, RN203.1 (4), RN203.2, RN203.3, RN203.4, RN204.8, U209.14 (VCC), U210.8 (VCC), U212.12 (3V)
/SAMD21_5V: C219.1, C220.1, R207.2, U211.2 (VO), U212.14 (5V)
/SAMD_CS_µSD: J207.3, U209.12 (A4), U212.2 (A1)
/SAMD_MISO: J207.5, U209.3 (B1), U212.10 (MI)
/SAMD_MOSI: J207.4, U209.5 (A2), U212.11 (MO)
/SAMD_SCK: J207.6, U209.9 (A3), U212.9 (SCK)
/SAMD_UART-RS485_DE: J208.2, U210.2 (~RE), U210.3 (DE), U212.5 (SDA)
/SAMD_UART-RS485_RX: J208.4, U210.1 (RO), U212.8 (RX)
/SAMD_UART-RS485_TX: J208.3, U210.4 (DI), U212.7 (TX)
/SAMD_µSD_BUS_CONNECT: J207.2, U209.1 (1~OE), U209.4 (2~OE), U209.10 (3~OE), U209.13 (4~OE), U212.1 (A0)
/STRAP_GPIO3: U104.15 (IO3)
/UART-RS485_RX: U104.20 (IO12), U107.1 (RO)
/UART-RS485_TX: U104.19 (IO11), U107.4 (DI)
/UART_RS485_DE: U104.23 (IO21), U107.2 (~RE), U107.3 (DE)
/µSD_SPI_CS: J103.7, J210.2 (DAT3/CD), RN203.7 (5), U105.11 (B4), U209.11 (B4)
/µSD_SPI_MISO: J103.9, J210.7 (DAT0), R201.2, RN203.8, U105.2 (A1)
/µSD_SPI_MISO_T: R201.1, U209.2 (A1)
/µSD_SPI_MOSI: J103.5, J210.3 (CMD), RN203.6, U105.6 (B2), U209.6 (B2)
/µSD_SPI_SCK: J103.3, J210.5 (CLK), RN203.5, U105.8 (B3), U209.8 (B3)
GND: C101.2, C102.2, C103.2, C104.2, C105.2, C106.2, C107.2, C108.2, C109.2, C110.2, C111.2, C112.2, C113.2, C114.2, C115.2, C116.2, C117.2, C118.2, C119.2, C120.2, C201.2, C217.2, C218.2, C219.2, C220.2, C221.2, C222.2, C223.2, D102.1 (K), D103.1 (K), D104.1 (K), D105.1 (K), D206.1 (K), D208.1 (K), J101.2, J102.3, J103.1, J103.2, J103.11, J103.12, J104.1 (GND), J104.7 (GND), J104.37 (GND), J104.S1 (M), J104.S2 (M), J105.2, J207.1, J208.1, J208.5, J209.1, J209.4, J210.6 (VSS), J210.9 (SHIELD), J211.2, J211.4, J211.6, J401.3, J401.4, J401.7, J401.8, J401.23, J401.24, J401.27, J401.28, J402.3, J402.4, J402.7, J402.8, J402.23, J402.24, J402.27, J402.28, J403.3, J403.4, J403.7, J403.8, J403.23, J403.24, J403.27, J403.28, J404.3, J404.4, J404.7, J404.8, J404.23, J404.24, J404.27, J404.28, R101.2, R102.2, R106.2, R107.2, R108.2, R109.2, U102.1 (GND), U103.4 (GND), U104.1 (GND), U104.40 (GND), U104.41 (GND), U105.7 (GND), U106.2 (GND), U107.5 (GND), U108.4 (GND), U108.9 (EP), U209.7 (GND), U210.5 (GND), U211.1 (GND), U212.13 (GND)
unnamed: D101.1 (K), R101.1
unnamed: D102.2 (A), RN102.1 (4)
unnamed: D103.2 (A), RN102.2
unnamed: D104.2 (A), RN102.3
unnamed: D105.2 (A), RN102.4
unnamed: D206.2 (A), R207.1
unnamed: D207.1 (K), R208.1
unnamed: D208.2 (A), R209.1
unnamed: C114.1, C116.1, J104.40 (LEDA), J105.1, U106.5 (V_{OUT})
unnamed: J104.38 (LEDK), R104.2
unnamed: J104.39 (LEDK), R105.2
unnamed: J210.CD (CHIP_DETECT), R208.2
unnamed: J211.3, RN204.5, RN204.7 (5)
unnamed: J211.5, RN204.4
unnamed: Q101.1 (G), R108.1, U101.3 (BIAS)
unnamed: Q102.1 (G), R109.1, U109.3 (BIAS)
unnamed: R106.1, U101.2 (REF)
unnamed: R102.1, R104.1, R105.1, U106.3 (FB)
unnamed: L101.2, U106.1 (SW)
unnamed: R107.1, U109.2 (REF)

Notes on the sheet:
Populate 120R Resistor If Last Panel In Chain
QTPy SAMD21 has +5V -> +3V3 Regulator Onboard "3V" Pin is the output from this regulator
Italics denote bootstrapping pins which go to weird states upon ESP32 reset. Be aware that these might be weird to get configured in software.
PCB EDGE CONNECTIONS
