twfth9/Morg_Grad_Cap/Grad/Hardware/grad_cap_display.kicad_pcb

## KiCad design Grad/Hardware/grad_cap_display.kicad_pcb (continued)

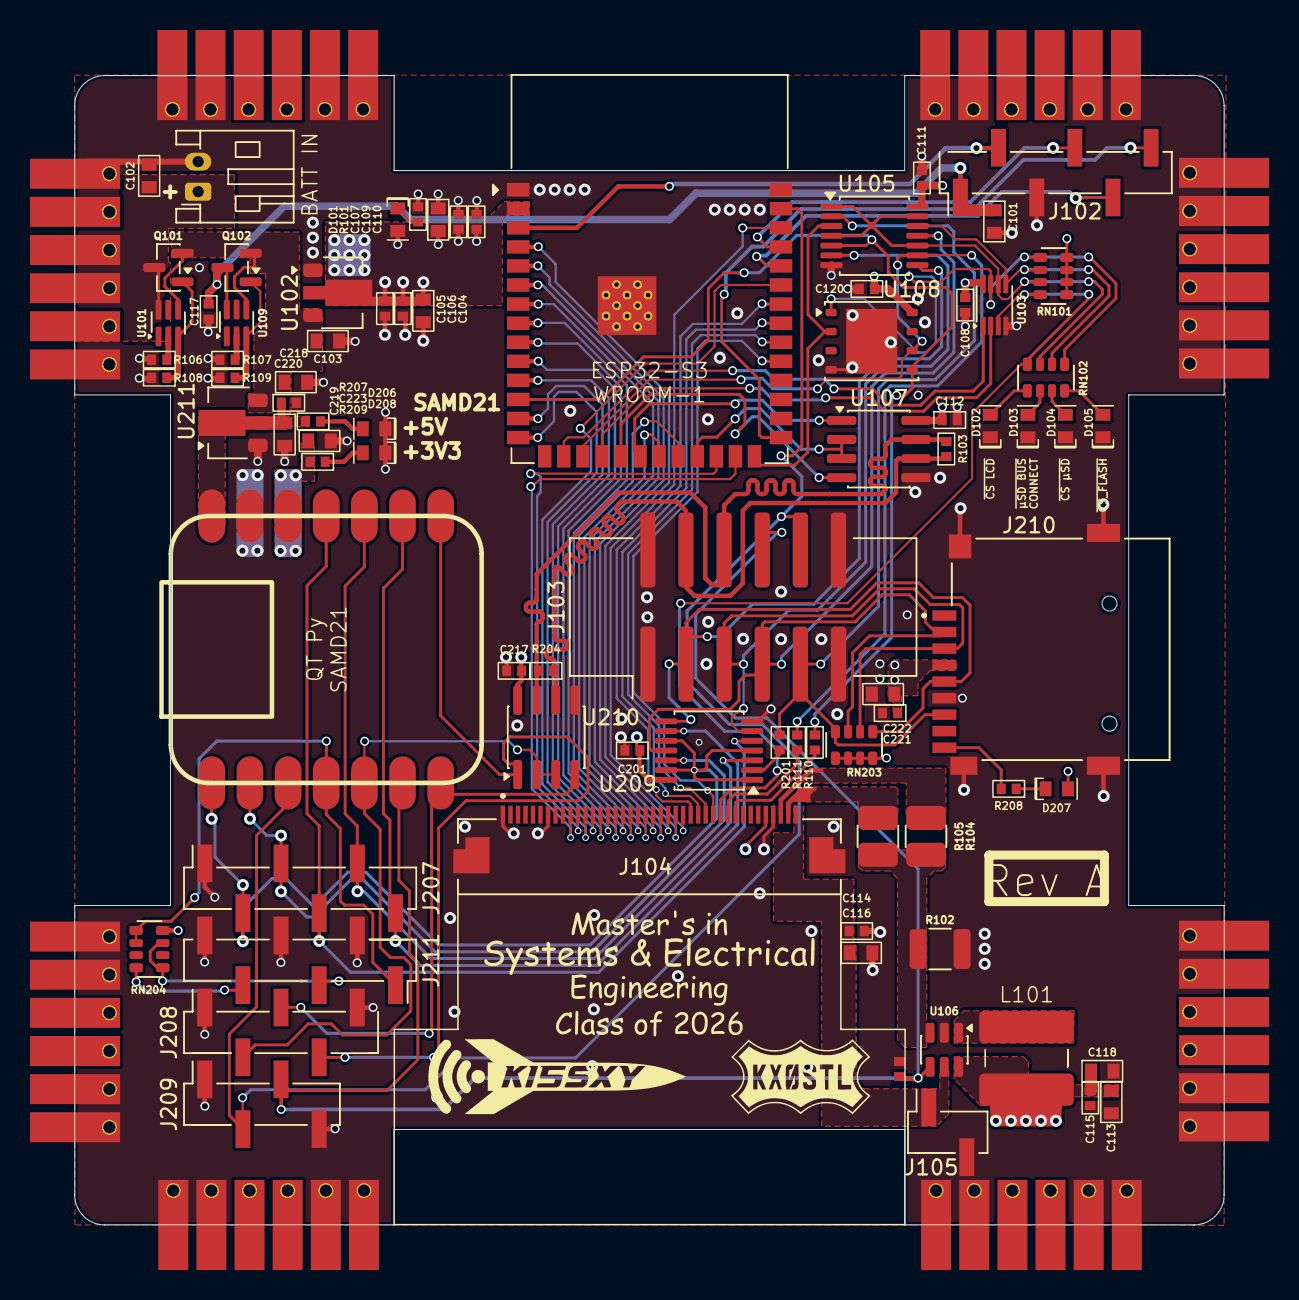
[picture p8: board Grad/Hardware/grad_cap_display.kicad_pcb from above]

Board: 4 copper layers, 76.5 x 76.5 mm, 86 parts (0 on the bottom side), 83 nets.
