twfth9/Morg_Grad_Cap/Grad/Hardware/Overview Design/grad_cap_display.kicad_pcb

## KiCad design Grad/Hardware/Overview Design/grad_cap_display.kicad_pcb (2026-02-15)

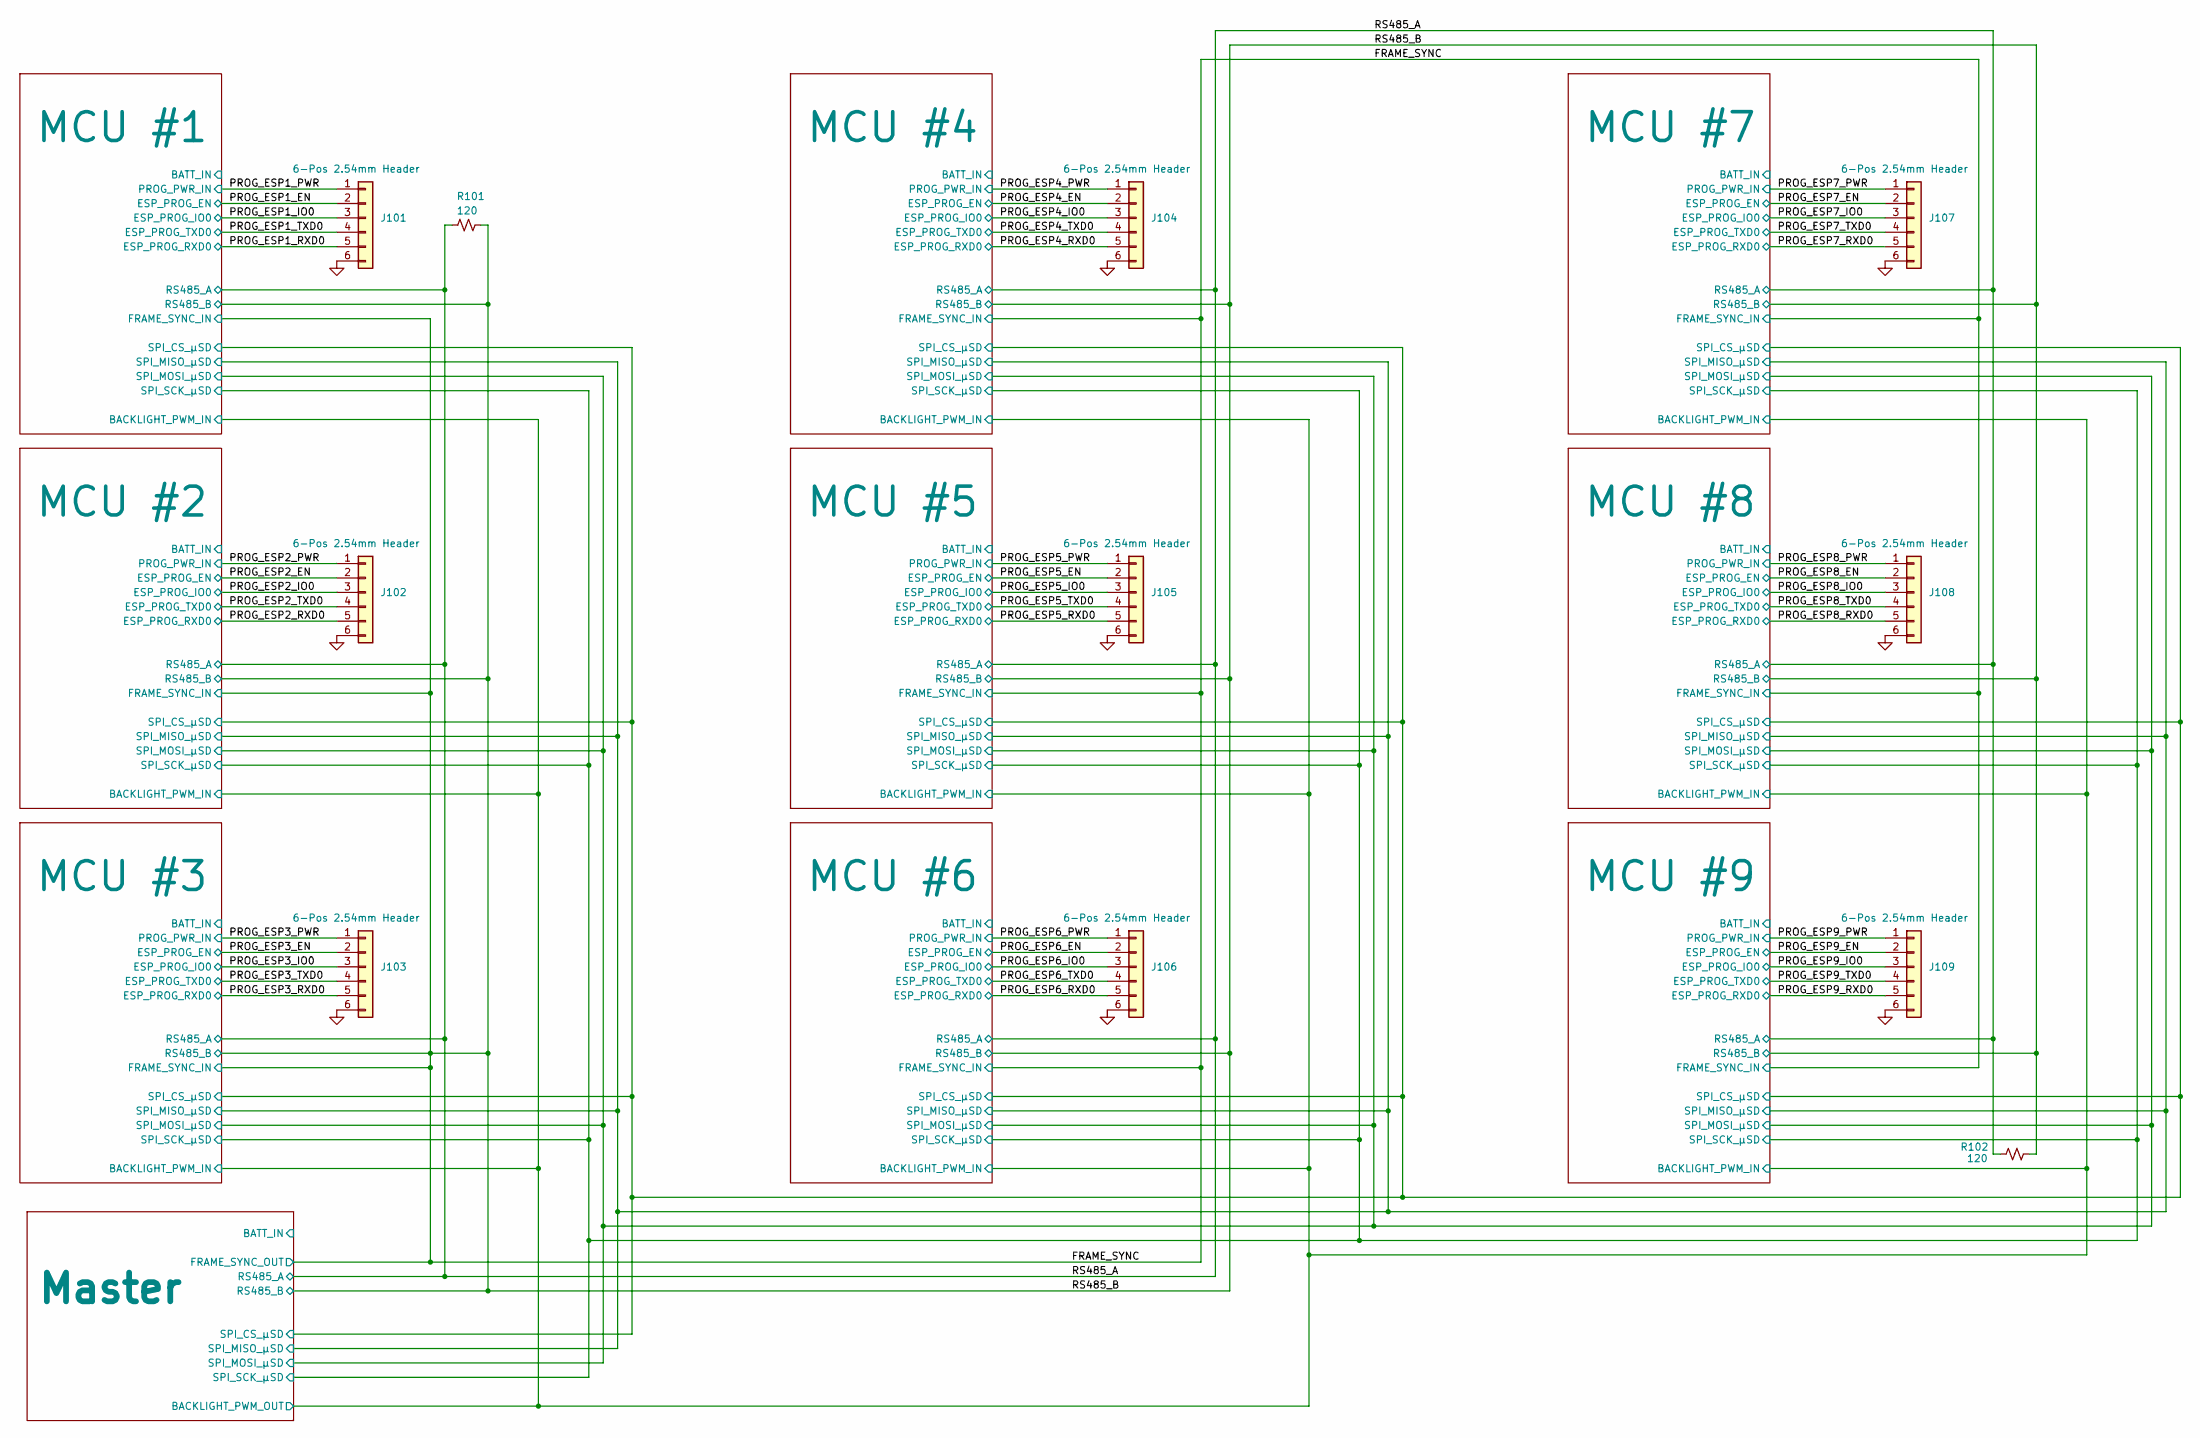
[picture p9: schematic grad_cap_display.kicad_sch]

Parts:
J101, J102, J103, J104, J105, J106, J107, J108, J109: 6-Pos 2.54mm Header; PinHeader_1x06_P2.54mm_Vertical
R101, R102: 120; Worthington_R_0402

Connections:
/FRAME_SYNC: R101.1, R102.2; also elsewhere on the board
/PROG_ESP1_EN: J101.2; also elsewhere on the board
/PROG_ESP1_IO0: J101.3; also elsewhere on the board
/PROG_ESP1_PWR: J101.1; also elsewhere on the board
/PROG_ESP1_RXD0: J101.5; also elsewhere on the board
/PROG_ESP1_TXD0: J101.4; also elsewhere on the board
/PROG_ESP2_EN: J102.2; also elsewhere on the board
/PROG_ESP2_IO0: J102.3; also elsewhere on the board
/PROG_ESP2_PWR: J102.1; also elsewhere on the board
/PROG_ESP2_RXD0: J102.5; also elsewhere on the board
/PROG_ESP2_TXD0: J102.4; also elsewhere on the board
/PROG_ESP3_EN: J103.2; also elsewhere on the board
/PROG_ESP3_IO0: J103.3; also elsewhere on the board
/PROG_ESP3_PWR: J103.1; also elsewhere on the board
/PROG_ESP3_RXD0: J103.5; also elsewhere on the board
/PROG_ESP3_TXD0: J103.4; also elsewhere on the board
/PROG_ESP4_EN: J104.2; also elsewhere on the board
/PROG_ESP4_IO0: J104.3; also elsewhere on the board
/PROG_ESP4_PWR: J104.1; also elsewhere on the board
/PROG_ESP4_RXD0: J104.5; also elsewhere on the board
/PROG_ESP4_TXD0: J104.4; also elsewhere on the board
/PROG_ESP5_EN: J105.2; also elsewhere on the board
/PROG_ESP5_IO0: J105.3; also elsewhere on the board
/PROG_ESP5_PWR: J105.1; also elsewhere on the board
/PROG_ESP5_RXD0: J105.5; also elsewhere on the board
/PROG_ESP5_TXD0: J105.4; also elsewhere on the board
/PROG_ESP6_EN: J106.2; also elsewhere on the board
/PROG_ESP6_IO0: J106.3; also elsewhere on the board
/PROG_ESP6_PWR: J106.1; also elsewhere on the board
/PROG_ESP6_RXD0: J106.5; also elsewhere on the board
/PROG_ESP6_TXD0: J106.4; also elsewhere on the board
/PROG_ESP7_EN: J107.2; also elsewhere on the board
/PROG_ESP7_IO0: J107.3; also elsewhere on the board
/PROG_ESP7_PWR: J107.1; also elsewhere on the board
/PROG_ESP7_RXD0: J107.5; also elsewhere on the board
/PROG_ESP7_TXD0: J107.4; also elsewhere on the board
/PROG_ESP8_EN: J108.2; also elsewhere on the board
/PROG_ESP8_IO0: J108.3; also elsewhere on the board
/PROG_ESP8_PWR: J108.1; also elsewhere on the board
/PROG_ESP8_RXD0: J108.5; also elsewhere on the board
/PROG_ESP8_TXD0: J108.4; also elsewhere on the board
/PROG_ESP9_EN: J109.2; also elsewhere on the board
/PROG_ESP9_IO0: J109.3; also elsewhere on the board
/PROG_ESP9_PWR: J109.1; also elsewhere on the board
/PROG_ESP9_RXD0: J109.5; also elsewhere on the board
/PROG_ESP9_TXD0: J109.4; also elsewhere on the board
/RS485_A: R101.2, R102.1; also elsewhere on the board
GND: J101.6, J102.6, J103.6, J104.6, J105.6, J106.6, J107.6, J108.6, J109.6; also elsewhere on the board
