twfth9/Morg_Grad_Cap/Grad/Hardware/Overview Design/grad_cap_display.kicad_pcb

## KiCad design Grad/Hardware/Overview Design/grad_cap_display.kicad_pcb (continued)

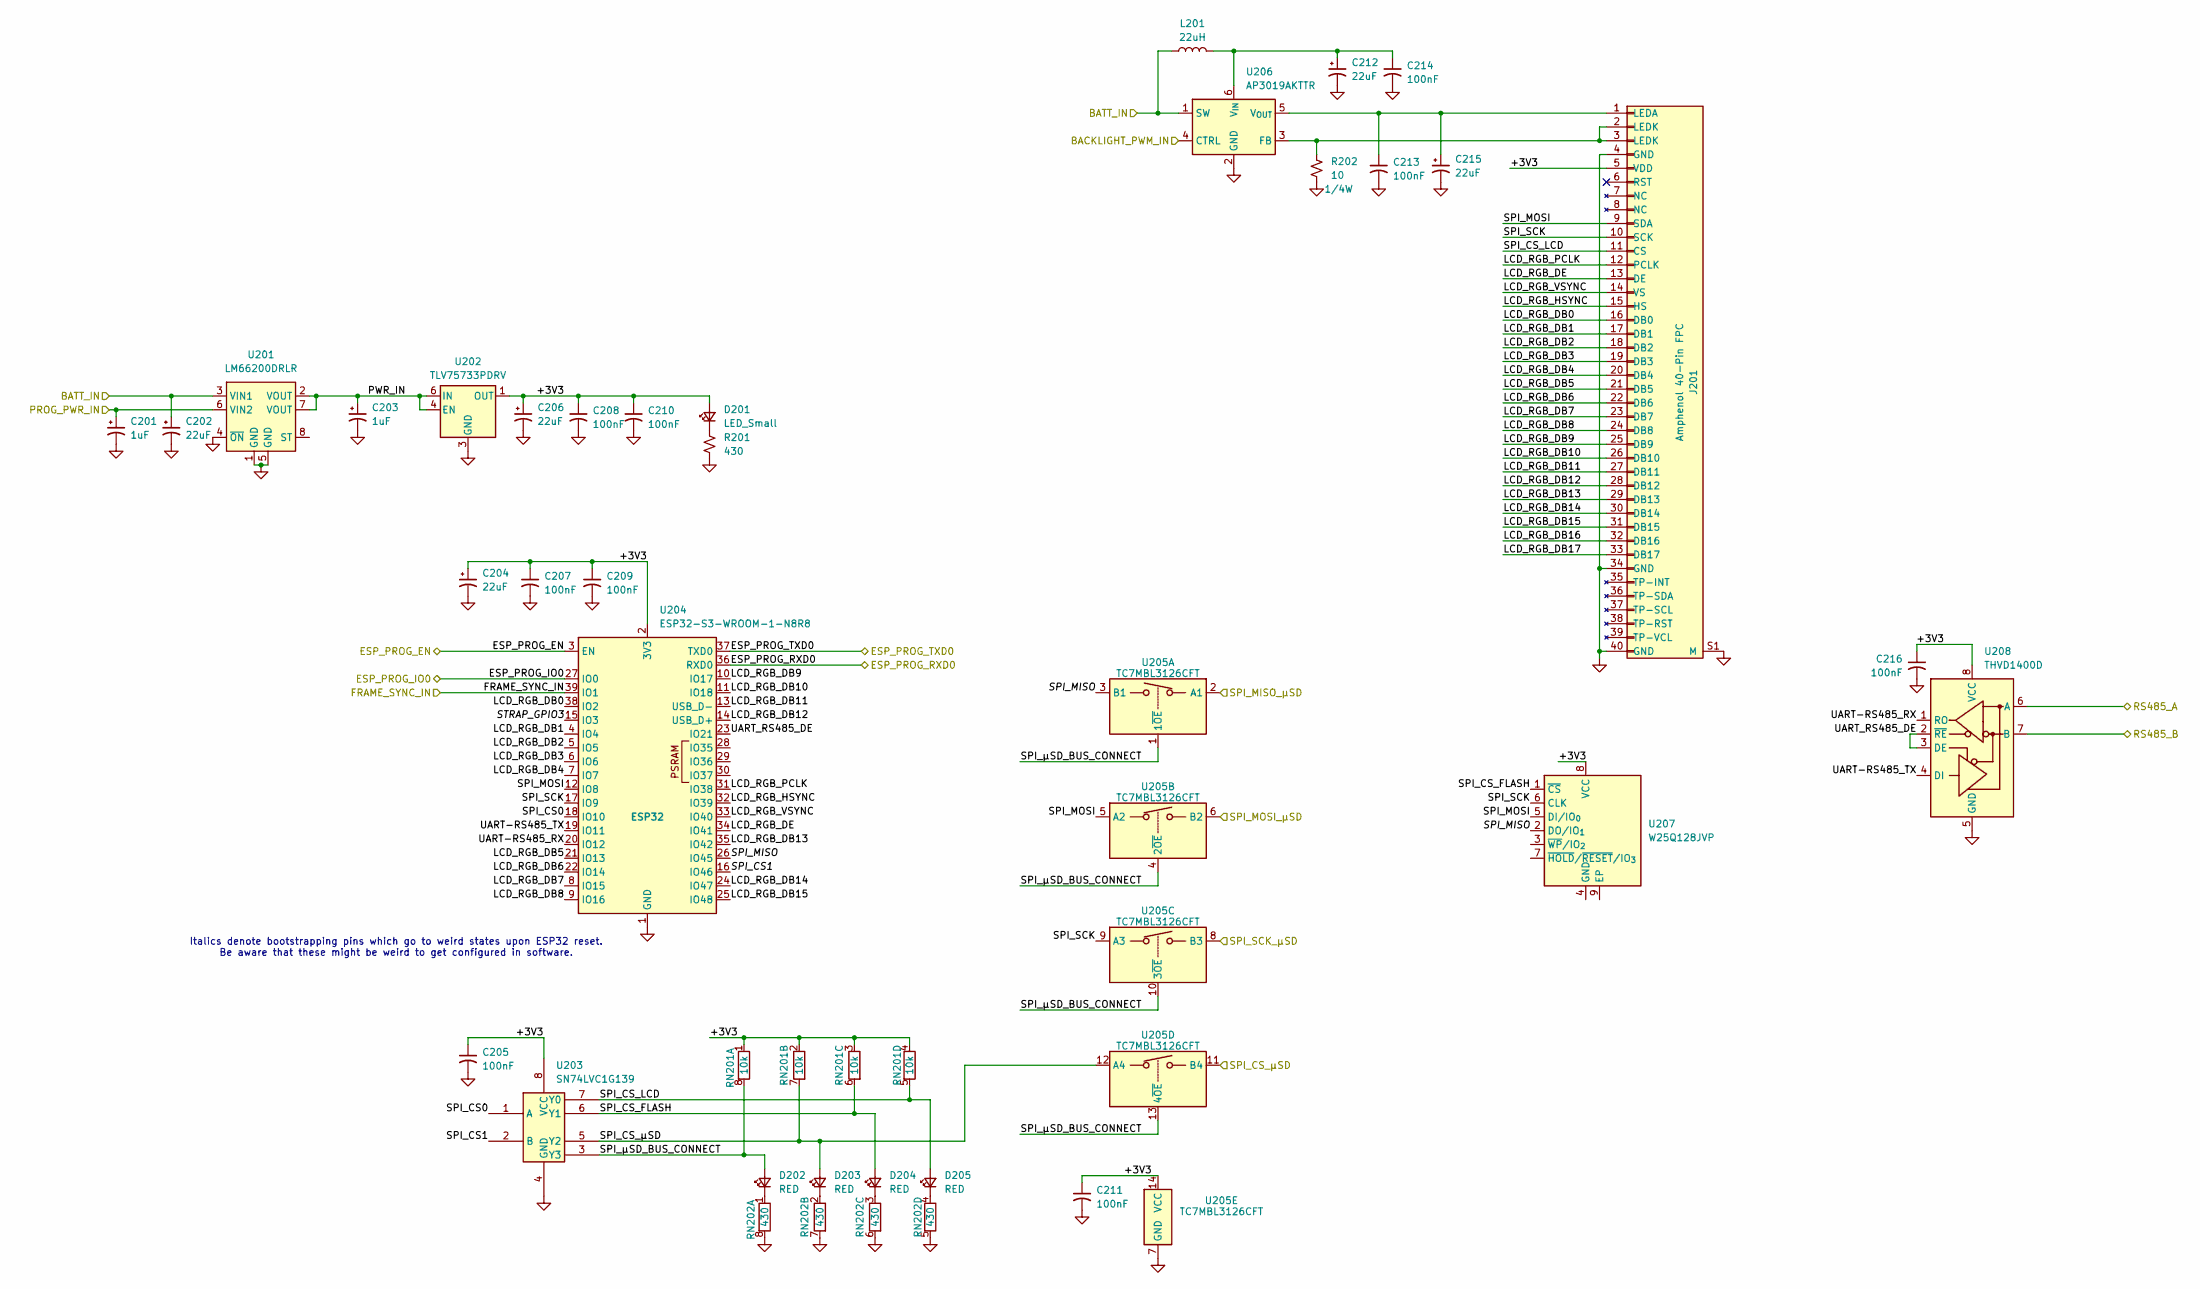
[picture p10: schematic ESP32_MASTER.kicad_sch]

Parts:
C201, C203: 1uF; Worthington_C_0603
C202, C204, C206, C215: 22uF; Worthington_C_0603
C205, C207, C208, C209, C210, C211, C213, C214, C216: 100nF; Worthington_C_0402
C212: 22uF; Worthington_D_0603
D201: LED_Small; Worthington_LED_0603
D202, D203, D204, D205: RED; Worthington_LED_0603
J201: Amphenol 40-Pin FPC; AMPHENOL_62684-402100ALF; DigiKey Part 62684-402100ALF
L201: 22uH; CDRH5D28
R201: 430; Worthington_R_0402
R202: 10; R_1210_3225Metric
RN201: 10k; RESCAXE80P320X160X70-8N; DigiKey Part CAY16-1002F4LFCT-ND
RN202: 430; RESCAXE80P320X160X70-8N; DigiKey Part 13-YC164-JR-07430RLCT-ND
U201: LM66200DRLR; SOT-583-8; DigiKey Part 296-LM66200DRLRCT-ND
U202: TLV75733PDRV; WSON-6-1EP_2x2mm_P0.65mm_EP1x1.6mm; DigiKey Part 296-50414-1-ND
U203: SN74LVC1G139; VSSOP-8_2.3x2mm_P0.5mm; DigiKey Part 296-18203-1-ND
U204: ESP32-S3-WROOM-1-N8R8; ESP32-S3-WROOM-1; DigiKey Part 5407-ESP32-S3-WROOM-1-N8R8CT-ND
U205: TC7MBL3126CFT; TSSOP-14_4.4x5mm_P0.65mm; DigiKey Part 264-TC7MBL3126CFT(EL)CT-ND
U206: AP3019AKTTR; TSOT-23-6; DigiKey Part Number AP3019AKTR-G1
U207: W25Q128JVP; WSON-8-1EP_6x5mm_P1.27mm_EP3.4x4.3mm; DigiKey Part 256-W25Q128JVPIQ-TUBE-ND
U208: THVD1400D; SOIC-8_3.9x4.9mm_P1.27mm; DigiKey Part 296-THVD1400DRCT-ND

Connections:
/ESP32 1/+3V3: C204.1, C205.1, C206.1, C207.1, C208.1, C209.1, C210.1, C211.1, C216.1, D201.2 (A), J201.5 (VDD), RN201.1 (4), RN201.2, RN201.3, RN201.4, U202.1 (OUT), U203.8 (VCC), U204.2 (3V3), U205.14 (VCC), U207.8 (VCC), U208.8 (VCC)
/ESP32 1/BATT_IN: C202.1, L201.1, U201.3 (VIN1), U206.1 (SW)
/ESP32 1/LCD_RGB_DB0: J201.16 (DB0), U204.38 (IO2)
/ESP32 1/LCD_RGB_DB1: J201.17 (DB1), U204.4 (IO4)
/ESP32 1/LCD_RGB_DB2: J201.18 (DB2), U204.5 (IO5)
/ESP32 1/LCD_RGB_DB3: J201.19 (DB3), U204.6 (IO6)
/ESP32 1/LCD_RGB_DB4: J201.20 (DB4), U204.7 (IO7)
/ESP32 1/LCD_RGB_DB5: J201.21 (DB5), U204.21 (IO13)
/ESP32 1/LCD_RGB_DB6: J201.22 (DB6), U204.22 (IO14)
/ESP32 1/LCD_RGB_DB7: J201.23 (DB7), U204.8 (IO15)
/ESP32 1/LCD_RGB_DB8: J201.24 (DB8), U204.9 (IO16)
/ESP32 1/LCD_RGB_DB9: J201.25 (DB9), U204.10 (IO17)
/ESP32 1/LCD_RGB_DB10: J201.26 (DB10), U204.11 (IO18)
/ESP32 1/LCD_RGB_DB11: J201.27 (DB11), U204.13 (USB_D-)
/ESP32 1/LCD_RGB_DB12: J201.28 (DB12), U204.14 (USB_D+)
/ESP32 1/LCD_RGB_DB13: J201.29 (DB13), U204.35 (IO42)
/ESP32 1/LCD_RGB_DB14: J201.30 (DB14), U204.24 (IO47)
/ESP32 1/LCD_RGB_DB15: J201.31 (DB15), U204.25 (IO48)
/ESP32 1/LCD_RGB_DB16: J201.32 (DB16)
/ESP32 1/LCD_RGB_DB17: J201.33 (DB17)
/ESP32 1/LCD_RGB_DE: J201.13 (DE), U204.34 (IO41)
/ESP32 1/LCD_RGB_HSYNC: J201.15 (HS), U204.32 (IO39)
/ESP32 1/LCD_RGB_PCLK: J201.12 (PCLK), U204.31 (IO38)
/ESP32 1/LCD_RGB_VSYNC: J201.14 (VS), U204.33 (IO40)
/ESP32 1/PWR_IN: C203.1, U201.2 (VOUT), U201.7 (VOUT), U202.4 (EN), U202.6 (IN)
/ESP32 1/SPI_CS0: U203.1 (A), U204.18 (IO10)
/ESP32 1/SPI_CS1: U203.2 (B), U204.16 (IO46)
/ESP32 1/SPI_CS_FLASH: D204.2 (A), RN201.6, U203.6 (Y1), U207.1 (~CS)
/ESP32 1/SPI_CS_LCD: D205.2 (A), J201.11 (CS), RN201.5, U203.7 (Y0)
/ESP32 1/SPI_CS_µSD: D203.2 (A), RN201.7 (5), U203.5 (Y2), U205.11 (B4), U205.12 (A4); also elsewhere on the board
/ESP32 1/SPI_MISO: U204.26 (IO45), U205.3 (B1), U207.2 (DO/IO_{1})
/ESP32 1/SPI_MOSI: J201.9 (SDA), U204.12 (IO8), U205.5 (A2), U207.5 (DI/IO_{0})
/ESP32 1/SPI_SCK: J201.10 (SCK), U204.17 (IO9), U205.9 (A3), U207.6 (CLK)
/ESP32 1/SPI_µSD_BUS_CONNECT: D202.2 (A), RN201.8, U203.3 (Y3), U205.1 (1~OE), U205.4 (2~OE), U205.10 (3~OE), U205.13 (4~OE)
/ESP32 1/STRAP_GPIO3: U204.15 (IO3)
/ESP32 1/UART-RS485_RX: U204.20 (IO12), U208.1 (RO)
/ESP32 1/UART-RS485_TX: U204.19 (IO11), U208.4 (DI)
/ESP32 1/UART_RS485_DE: U204.23 (IO21), U208.2 (~RE), U208.3 (DE)
/FRAME_SYNC: U204.39 (IO1), U208.7 (B); also elsewhere on the board
/PROG_ESP1_EN: U204.3 (EN); also elsewhere on the board
/PROG_ESP1_IO0: U204.27 (IO0); also elsewhere on the board
/PROG_ESP1_PWR: C201.1, U201.6 (VIN2); also elsewhere on the board
/PROG_ESP1_RXD0: U204.36 (RXD0); also elsewhere on the board
/PROG_ESP1_TXD0: U204.37 (TXD0); also elsewhere on the board
/RS485_A: U208.6 (A); also elsewhere on the board
/SAMD21/BACKLIGHT_PWM: U206.4 (CTRL); also elsewhere on the board
/SAMD21/SPI_MISO_µSD: U205.2 (A1); also elsewhere on the board
/SAMD21/SPI_MOSI_µSD: U205.6 (B2); also elsewhere on the board
/SAMD21/SPI_SCK_µSD: U205.8 (B3); also elsewhere on the board
GND: C201.2, C202.2, C203.2, C204.2, C205.2, C206.2, C207.2, C208.2, C209.2, C210.2, C211.2, C212.2, C213.2, C214.2, C215.2, C216.2, J201.4 (GND), J201.34 (GND), J201.40 (GND), J201.S1 (M), J201.S2 (M), R201.2, R202.2, RN202.5, RN202.6, RN202.7 (5), RN202.8, U201.1 (GND), U201.4 (~ON), U201.5 (GND), U202.3 (GND), U202.7 (GND), U203.4 (GND), U204.1 (GND), U204.40 (GND), U204.41 (GND), U205.7 (GND), U206.2 (GND), U208.5 (GND); also elsewhere on the board
unnamed: D201.1 (K), R201.1
unnamed: D202.1 (K), RN202.1 (4)
unnamed: D203.1 (K), RN202.2
unnamed: D204.1 (K), RN202.3
unnamed: D205.1 (K), RN202.4
unnamed: C213.1, C215.1, J201.1 (LEDA), U206.5 (V_{OUT})
unnamed: J201.2 (LEDK), J201.3 (LEDK), R202.1, U206.3 (FB)
unnamed: C212.1, C214.1, L201.2, U206.6 (V_{IN})

Parts of its further copies:
C301, C303, C401, C403, C501, C503, C601, C603, C701, C703, C801, C803, C901, C903, C1001, C1003: 1uF; Worthington_C_0603
C302, C304, C306, C315, C402, C404, C406, C415, C502, C504, C506, C515, C602, C604, C606, C615, C702, C704, C706, C715, C802, C804, C806, C815, C902, C904, C906, C915, C1002, C1004, C1006, C1015: 22uF; Worthington_C_0603
C305, C307, C308, C309, C310, C311, C313, C314, C316, C405, C407, C408, C409, C410, C411, C413, C414, C416, C505, C507, C508, C509, C510, C511, C513, C514, C516, C605, C607, C608, C609, C610, C611, C613, C614, C616, C705, C707, C708, C709, C710, C711, C713, C714, C716, C805, C807, C808, C809, C810, C811, C813, C814, C816, C905, C907, C908, C909, C910, C911, C913, C914, C916, C1005, C1007, C1008, C1009, C1010, C1011, C1013, C1014, C1016: 100nF; Worthington_C_0402
C312, C412, C512, C612, C712, C812, C912, C1012: 22uF; Worthington_D_0603
D301, D401, D501, D601, D701, D801, D901, D1001: LED_Small; Worthington_LED_0603
D302, D303, D304, D305, D402, D403, D404, D405, D502, D503, D504, D505, D602, D603, D604, D605, D702, D703, D704, D705, D802, D803, D804, D805, D902, D903, D904, D905, D1002, D1003, D1004, D1005: RED; Worthington_LED_0603
J301, J401, J501, J601, J701, J801, J901, J1001: Amphenol 40-Pin FPC; AMPHENOL_62684-402100ALF; DigiKey Part 62684-402100ALF
L301, L401, L501, L601, L701, L801, L901, L1001: 22uH; CDRH5D28
R301, R401, R501, R601, R701, R801, R901, R1001: 430; Worthington_R_0402
R302, R402, R502, R602, R702, R802, R902, R1002: 10; R_1210_3225Metric
RN301, RN401, RN501, RN601, RN701, RN801, RN901, RN1001: 10k; RESCAXE80P320X160X70-8N; DigiKey Part CAY16-1002F4LFCT-ND
RN302, RN402, RN502, RN602, RN702, RN802, RN902, RN1002: 430; RESCAXE80P320X160X70-8N; DigiKey Part 13-YC164-JR-07430RLCT-ND
U301, U401, U501, U601, U701, U801, U901, U1001: LM66200DRLR; SOT-583-8; DigiKey Part 296-LM66200DRLRCT-ND
U302, U402, U502, U602, U702, U802, U902, U1002: TLV75733PDRV; WSON-6-1EP_2x2mm_P0.65mm_EP1x1.6mm; DigiKey Part 296-50414-1-ND
U303, U403, U503, U603, U703, U803, U903, U1003: SN74LVC1G139; VSSOP-8_2.3x2mm_P0.5mm; DigiKey Part 296-18203-1-ND
U304, U404, U504, U604, U704, U804, U904, U1004: ESP32-S3-WROOM-1-N8R8; ESP32-S3-WROOM-1; DigiKey Part 5407-ESP32-S3-WROOM-1-N8R8CT-ND
U305, U405, U505, U605, U705, U805, U905, U1005: TC7MBL3126CFT; TSSOP-14_4.4x5mm_P0.65mm; DigiKey Part 264-TC7MBL3126CFT(EL)CT-ND
U306, U406, U506, U606, U706, U806, U906, U1006: AP3019AKTTR; TSOT-23-6; DigiKey Part Number AP3019AKTR-G1
U307, U407, U507, U607, U707, U807, U907, U1007: W25Q128JVP; WSON-8-1EP_6x5mm_P1.27mm_EP3.4x4.3mm; DigiKey Part 256-W25Q128JVPIQ-TUBE-ND
U308, U408, U508, U608, U708, U808, U908, U1008: THVD1400D; SOIC-8_3.9x4.9mm_P1.27mm; DigiKey Part 296-THVD1400DRCT-ND

Connections of its further copies:
/ESP32 1/SPI_CS_µSD: D303.2 (A), D403.2 (A), D503.2 (A), D603.2 (A), D703.2 (A), D803.2 (A), D903.2 (A), D1003.2 (A), RN301.7 (5), RN401.7 (5), RN501.7 (5), RN601.7 (5), RN701.7 (5), RN801.7 (5), RN901.7 (5), RN1001.7 (5), U303.5 (Y2), U305.11 (B4), U305.12 (A4), U403.5 (Y2), U405.11 (B4), U405.12 (A4), U503.5 (Y2), U505.11 (B4), U505.12 (A4), U603.5 (Y2), U605.11 (B4), U605.12 (A4), U703.5 (Y2), U705.11 (B4), U705.12 (A4), U803.5 (Y2), U805.11 (B4), U805.12 (A4), U903.5 (Y2), U905.11 (B4), U905.12 (A4), U1003.5 (Y2), U1005.11 (B4), U1005.12 (A4); also elsewhere on the board
/ESP32 2/+3V3: C304.1, C305.1, C306.1, C307.1, C308.1, C309.1, C310.1, C311.1, C316.1, D301.2 (A), J301.5 (VDD), RN301.1 (4), RN301.2, RN301.3, RN301.4, U302.1 (OUT), U303.8 (VCC), U304.2 (3V3), U305.14 (VCC), U307.8 (VCC), U308.8 (VCC)
/ESP32 2/BATT_IN: C302.1, L301.1, U301.3 (VIN1), U306.1 (SW)
/ESP32 2/LCD_RGB_DB0: J301.16 (DB0), U304.38 (IO2)
/ESP32 2/LCD_RGB_DB1: J301.17 (DB1), U304.4 (IO4)
/ESP32 2/LCD_RGB_DB2: J301.18 (DB2), U304.5 (IO5)
/ESP32 2/LCD_RGB_DB3: J301.19 (DB3), U304.6 (IO6)
/ESP32 2/LCD_RGB_DB4: J301.20 (DB4), U304.7 (IO7)
/ESP32 2/LCD_RGB_DB5: J301.21 (DB5), U304.21 (IO13)
/ESP32 2/LCD_RGB_DB6: J301.22 (DB6), U304.22 (IO14)
/ESP32 2/LCD_RGB_DB7: J301.23 (DB7), U304.8 (IO15)
/ESP32 2/LCD_RGB_DB8: J301.24 (DB8), U304.9 (IO16)
/ESP32 2/LCD_RGB_DB9: J301.25 (DB9), U304.10 (IO17)
/ESP32 2/LCD_RGB_DB10: J301.26 (DB10), U304.11 (IO18)
/ESP32 2/LCD_RGB_DB11: J301.27 (DB11), U304.13 (USB_D-)
/ESP32 2/LCD_RGB_DB12: J301.28 (DB12), U304.14 (USB_D+)
/ESP32 2/LCD_RGB_DB13: J301.29 (DB13), U304.35 (IO42)
/ESP32 2/LCD_RGB_DB14: J301.30 (DB14), U304.24 (IO47)
/ESP32 2/LCD_RGB_DB15: J301.31 (DB15), U304.25 (IO48)
/ESP32 2/LCD_RGB_DB16: J301.32 (DB16)
/ESP32 2/LCD_RGB_DB17: J301.33 (DB17)
/ESP32 2/LCD_RGB_DE: J301.13 (DE), U304.34 (IO41)
/ESP32 2/LCD_RGB_HSYNC: J301.15 (HS), U304.32 (IO39)
/ESP32 2/LCD_RGB_PCLK: J301.12 (PCLK), U304.31 (IO38)
/ESP32 2/LCD_RGB_VSYNC: J301.14 (VS), U304.33 (IO40)
/ESP32 2/PWR_IN: C303.1, U301.2 (VOUT), U301.7 (VOUT), U302.4 (EN), U302.6 (IN)
/ESP32 2/SPI_CS0: U303.1 (A), U304.18 (IO10)
/ESP32 2/SPI_CS1: U303.2 (B), U304.16 (IO46)
/ESP32 2/SPI_CS_FLASH: D304.2 (A), RN301.6, U303.6 (Y1), U307.1 (~CS)
/ESP32 2/SPI_CS_LCD: D305.2 (A), J301.11 (CS), RN301.5, U303.7 (Y0)
/ESP32 2/SPI_MISO: U304.26 (IO45), U305.3 (B1), U307.2 (DO/IO_{1})
/ESP32 2/SPI_MOSI: J301.9 (SDA), U304.12 (IO8), U305.5 (A2), U307.5 (DI/IO_{0})
/ESP32 2/SPI_SCK: J301.10 (SCK), U304.17 (IO9), U305.9 (A3), U307.6 (CLK)
/ESP32 2/SPI_µSD_BUS_CONNECT: D302.2 (A), RN301.8, U303.3 (Y3), U305.1 (1~OE), U305.4 (2~OE), U305.10 (3~OE), U305.13 (4~OE)
/ESP32 2/STRAP_GPIO3: U304.15 (IO3)
/ESP32 2/UART-RS485_RX: U304.20 (IO12), U308.1 (RO)
/ESP32 2/UART-RS485_TX: U304.19 (IO11), U308.4 (DI)
/ESP32 2/UART_RS485_DE: U304.23 (IO21), U308.2 (~RE), U308.3 (DE)
/ESP32 3/+3V3: C404.1, C405.1, C406.1, C407.1, C408.1, C409.1, C410.1, C411.1, C416.1, D401.2 (A), J401.5 (VDD), RN401.1 (4), RN401.2, RN401.3, RN401.4, U402.1 (OUT), U403.8 (VCC), U404.2 (3V3), U405.14 (VCC), U407.8 (VCC), U408.8 (VCC)
/ESP32 3/BATT_IN: C402.1, L401.1, U401.3 (VIN1), U406.1 (SW)
/ESP32 3/LCD_RGB_DB0: J401.16 (DB0), U404.38 (IO2)
/ESP32 3/LCD_RGB_DB1: J401.17 (DB1), U404.4 (IO4)
/ESP32 3/LCD_RGB_DB2: J401.18 (DB2), U404.5 (IO5)
/ESP32 3/LCD_RGB_DB3: J401.19 (DB3), U404.6 (IO6)
/ESP32 3/LCD_RGB_DB4: J401.20 (DB4), U404.7 (IO7)
/ESP32 3/LCD_RGB_DB5: J401.21 (DB5), U404.21 (IO13)
/ESP32 3/LCD_RGB_DB6: J401.22 (DB6), U404.22 (IO14)
/ESP32 3/LCD_RGB_DB7: J401.23 (DB7), U404.8 (IO15)
/ESP32 3/LCD_RGB_DB8: J401.24 (DB8), U404.9 (IO16)
/ESP32 3/LCD_RGB_DB9: J401.25 (DB9), U404.10 (IO17)
/ESP32 3/LCD_RGB_DB10: J401.26 (DB10), U404.11 (IO18)
/ESP32 3/LCD_RGB_DB11: J401.27 (DB11), U404.13 (USB_D-)
/ESP32 3/LCD_RGB_DB12: J401.28 (DB12), U404.14 (USB_D+)
/ESP32 3/LCD_RGB_DB13: J401.29 (DB13), U404.35 (IO42)
/ESP32 3/LCD_RGB_DB14: J401.30 (DB14), U404.24 (IO47)
/ESP32 3/LCD_RGB_DB15: J401.31 (DB15), U404.25 (IO48)
/ESP32 3/LCD_RGB_DB16: J401.32 (DB16)
/ESP32 3/LCD_RGB_DB17: J401.33 (DB17)
/ESP32 3/LCD_RGB_DE: J401.13 (DE), U404.34 (IO41)
/ESP32 3/LCD_RGB_HSYNC: J401.15 (HS), U404.32 (IO39)
/ESP32 3/LCD_RGB_PCLK: J401.12 (PCLK), U404.31 (IO38)
/ESP32 3/LCD_RGB_VSYNC: J401.14 (VS), U404.33 (IO40)
/ESP32 3/PWR_IN: C403.1, U401.2 (VOUT), U401.7 (VOUT), U402.4 (EN), U402.6 (IN)
/ESP32 3/SPI_CS0: U403.1 (A), U404.18 (IO10)
/ESP32 3/SPI_CS1: U403.2 (B), U404.16 (IO46)
/ESP32 3/SPI_CS_FLASH: D404.2 (A), RN401.6, U403.6 (Y1), U407.1 (~CS)
/ESP32 3/SPI_CS_LCD: D405.2 (A), J401.11 (CS), RN401.5, U403.7 (Y0)
/ESP32 3/SPI_MISO: U404.26 (IO45), U405.3 (B1), U407.2 (DO/IO_{1})
/ESP32 3/SPI_MOSI: J401.9 (SDA), U404.12 (IO8), U405.5 (A2), U407.5 (DI/IO_{0})
/ESP32 3/SPI_SCK: J401.10 (SCK), U404.17 (IO9), U405.9 (A3), U407.6 (CLK)
/ESP32 3/SPI_µSD_BUS_CONNECT: D402.2 (A), RN401.8, U403.3 (Y3), U405.1 (1~OE), U405.4 (2~OE), U405.10 (3~OE), U405.13 (4~OE)
/ESP32 3/STRAP_GPIO3: U404.15 (IO3)
/ESP32 3/UART-RS485_RX: U404.20 (IO12), U408.1 (RO)
/ESP32 3/UART-RS485_TX: U404.19 (IO11), U408.4 (DI)
/ESP32 3/UART_RS485_DE: U404.23 (IO21), U408.2 (~RE), U408.3 (DE)
/ESP32 4/+3V3: C504.1, C505.1, C506.1, C507.1, C508.1, C509.1, C510.1, C511.1, C516.1, D501.2 (A), J501.5 (VDD), RN501.1 (4), RN501.2, RN501.3, RN501.4, U502.1 (OUT), U503.8 (VCC), U504.2 (3V3), U505.14 (VCC), U507.8 (VCC), U508.8 (VCC)
/ESP32 4/BATT_IN: C502.1, L501.1, U501.3 (VIN1), U506.1 (SW)
/ESP32 4/LCD_RGB_DB0: J501.16 (DB0), U504.38 (IO2)
/ESP32 4/LCD_RGB_DB1: J501.17 (DB1), U504.4 (IO4)
/ESP32 4/LCD_RGB_DB2: J501.18 (DB2), U504.5 (IO5)
/ESP32 4/LCD_RGB_DB3: J501.19 (DB3), U504.6 (IO6)
/ESP32 4/LCD_RGB_DB4: J501.20 (DB4), U504.7 (IO7)
/ESP32 4/LCD_RGB_DB5: J501.21 (DB5), U504.21 (IO13)
/ESP32 4/LCD_RGB_DB6: J501.22 (DB6), U504.22 (IO14)
/ESP32 4/LCD_RGB_DB7: J501.23 (DB7), U504.8 (IO15)
/ESP32 4/LCD_RGB_DB8: J501.24 (DB8), U504.9 (IO16)
/ESP32 4/LCD_RGB_DB9: J501.25 (DB9), U504.10 (IO17)
/ESP32 4/LCD_RGB_DB10: J501.26 (DB10), U504.11 (IO18)
/ESP32 4/LCD_RGB_DB11: J501.27 (DB11), U504.13 (USB_D-)
/ESP32 4/LCD_RGB_DB12: J501.28 (DB12), U504.14 (USB_D+)
/ESP32 4/LCD_RGB_DB13: J501.29 (DB13), U504.35 (IO42)
/ESP32 4/LCD_RGB_DB14: J501.30 (DB14), U504.24 (IO47)
/ESP32 4/LCD_RGB_DB15: J501.31 (DB15), U504.25 (IO48)
/ESP32 4/LCD_RGB_DB16: J501.32 (DB16)
/ESP32 4/LCD_RGB_DB17: J501.33 (DB17)
/ESP32 4/LCD_RGB_DE: J501.13 (DE), U504.34 (IO41)
/ESP32 4/LCD_RGB_HSYNC: J501.15 (HS), U504.32 (IO39)
/ESP32 4/LCD_RGB_PCLK: J501.12 (PCLK), U504.31 (IO38)
/ESP32 4/LCD_RGB_VSYNC: J501.14 (VS), U504.33 (IO40)
/ESP32 4/PWR_IN: C503.1, U501.2 (VOUT), U501.7 (VOUT), U502.4 (EN), U502.6 (IN)
/ESP32 4/SPI_CS0: U503.1 (A), U504.18 (IO10)
/ESP32 4/SPI_CS1: U503.2 (B), U504.16 (IO46)
/ESP32 4/SPI_CS_FLASH: D504.2 (A), RN501.6, U503.6 (Y1), U507.1 (~CS)
/ESP32 4/SPI_CS_LCD: D505.2 (A), J501.11 (CS), RN501.5, U503.7 (Y0)
/ESP32 4/SPI_MISO: U504.26 (IO45), U505.3 (B1), U507.2 (DO/IO_{1})
/ESP32 4/SPI_MOSI: J501.9 (SDA), U504.12 (IO8), U505.5 (A2), U507.5 (DI/IO_{0})
/ESP32 4/SPI_SCK: J501.10 (SCK), U504.17 (IO9), U505.9 (A3), U507.6 (CLK)
/ESP32 4/SPI_µSD_BUS_CONNECT: D502.2 (A), RN501.8, U503.3 (Y3), U505.1 (1~OE), U505.4 (2~OE), U505.10 (3~OE), U505.13 (4~OE)
/ESP32 4/STRAP_GPIO3: U504.15 (IO3)
/ESP32 4/UART-RS485_RX: U504.20 (IO12), U508.1 (RO)
/ESP32 4/UART-RS485_TX: U504.19 (IO11), U508.4 (DI)
/ESP32 4/UART_RS485_DE: U504.23 (IO21), U508.2 (~RE), U508.3 (DE)
/ESP32 5/+3V3: C604.1, C605.1, C606.1, C607.1, C608.1, C609.1, C610.1, C611.1, C616.1, D601.2 (A), J601.5 (VDD), RN601.1 (4), RN601.2, RN601.3, RN601.4, U602.1 (OUT), U603.8 (VCC), U604.2 (3V3), U605.14 (VCC), U607.8 (VCC), U608.8 (VCC)
/ESP32 5/BATT_IN: C602.1, L601.1, U601.3 (VIN1), U606.1 (SW)
/ESP32 5/LCD_RGB_DB0: J601.16 (DB0), U604.38 (IO2)
/ESP32 5/LCD_RGB_DB1: J601.17 (DB1), U604.4 (IO4)
/ESP32 5/LCD_RGB_DB2: J601.18 (DB2), U604.5 (IO5)
/ESP32 5/LCD_RGB_DB3: J601.19 (DB3), U604.6 (IO6)
/ESP32 5/LCD_RGB_DB4: J601.20 (DB4), U604.7 (IO7)
/ESP32 5/LCD_RGB_DB5: J601.21 (DB5), U604.21 (IO13)
/ESP32 5/LCD_RGB_DB6: J601.22 (DB6), U604.22 (IO14)
/ESP32 5/LCD_RGB_DB7: J601.23 (DB7), U604.8 (IO15)
/ESP32 5/LCD_RGB_DB8: J601.24 (DB8), U604.9 (IO16)
/ESP32 5/LCD_RGB_DB9: J601.25 (DB9), U604.10 (IO17)
/ESP32 5/LCD_RGB_DB10: J601.26 (DB10), U604.11 (IO18)
/ESP32 5/LCD_RGB_DB11: J601.27 (DB11), U604.13 (USB_D-)
/ESP32 5/LCD_RGB_DB12: J601.28 (DB12), U604.14 (USB_D+)
/ESP32 5/LCD_RGB_DB13: J601.29 (DB13), U604.35 (IO42)
/ESP32 5/LCD_RGB_DB14: J601.30 (DB14), U604.24 (IO47)
/ESP32 5/LCD_RGB_DB15: J601.31 (DB15), U604.25 (IO48)
/ESP32 5/LCD_RGB_DB16: J601.32 (DB16)
/ESP32 5/LCD_RGB_DB17: J601.33 (DB17)
/ESP32 5/LCD_RGB_DE: J601.13 (DE), U604.34 (IO41)
/ESP32 5/LCD_RGB_HSYNC: J601.15 (HS), U604.32 (IO39)
/ESP32 5/LCD_RGB_PCLK: J601.12 (PCLK), U604.31 (IO38)
/ESP32 5/LCD_RGB_VSYNC: J601.14 (VS), U604.33 (IO40)
/ESP32 5/PWR_IN: C603.1, U601.2 (VOUT), U601.7 (VOUT), U602.4 (EN), U602.6 (IN)
/ESP32 5/SPI_CS0: U603.1 (A), U604.18 (IO10)
/ESP32 5/SPI_CS1: U603.2 (B), U604.16 (IO46)
/ESP32 5/SPI_CS_FLASH: D604.2 (A), RN601.6, U603.6 (Y1), U607.1 (~CS)
/ESP32 5/SPI_CS_LCD: D605.2 (A), J601.11 (CS), RN601.5, U603.7 (Y0)
/ESP32 5/SPI_MISO: U604.26 (IO45), U605.3 (B1), U607.2 (DO/IO_{1})
/ESP32 5/SPI_MOSI: J601.9 (SDA), U604.12 (IO8), U605.5 (A2), U607.5 (DI/IO_{0})
/ESP32 5/SPI_SCK: J601.10 (SCK), U604.17 (IO9), U605.9 (A3), U607.6 (CLK)
/ESP32 5/SPI_µSD_BUS_CONNECT: D602.2 (A), RN601.8, U603.3 (Y3), U605.1 (1~OE), U605.4 (2~OE), U605.10 (3~OE), U605.13 (4~OE)
/ESP32 5/STRAP_GPIO3: U604.15 (IO3)
/ESP32 5/UART-RS485_RX: U604.20 (IO12), U608.1 (RO)
/ESP32 5/UART-RS485_TX: U604.19 (IO11), U608.4 (DI)
/ESP32 5/UART_RS485_DE: U604.23 (IO21), U608.2 (~RE), U608.3 (DE)
/ESP32 6/+3V3: C704.1, C705.1, C706.1, C707.1, C708.1, C709.1, C710.1, C711.1, C716.1, D701.2 (A), J701.5 (VDD), RN701.1 (4), RN701.2, RN701.3, RN701.4, U702.1 (OUT), U703.8 (VCC), U704.2 (3V3), U705.14 (VCC), U707.8 (VCC), U708.8 (VCC)
/ESP32 6/BATT_IN: C702.1, L701.1, U701.3 (VIN1), U706.1 (SW)
/ESP32 6/LCD_RGB_DB0: J701.16 (DB0), U704.38 (IO2)
/ESP32 6/LCD_RGB_DB1: J701.17 (DB1), U704.4 (IO4)
/ESP32 6/LCD_RGB_DB2: J701.18 (DB2), U704.5 (IO5)
/ESP32 6/LCD_RGB_DB3: J701.19 (DB3), U704.6 (IO6)
/ESP32 6/LCD_RGB_DB4: J701.20 (DB4), U704.7 (IO7)
/ESP32 6/LCD_RGB_DB5: J701.21 (DB5), U704.21 (IO13)
/ESP32 6/LCD_RGB_DB6: J701.22 (DB6), U704.22 (IO14)
/ESP32 6/LCD_RGB_DB7: J701.23 (DB7), U704.8 (IO15)
/ESP32 6/LCD_RGB_DB8: J701.24 (DB8), U704.9 (IO16)
/ESP32 6/LCD_RGB_DB9: J701.25 (DB9), U704.10 (IO17)
/ESP32 6/LCD_RGB_DB10: J701.26 (DB10), U704.11 (IO18)
/ESP32 6/LCD_RGB_DB11: J701.27 (DB11), U704.13 (USB_D-)
/ESP32 6/LCD_RGB_DB12: J701.28 (DB12), U704.14 (USB_D+)
/ESP32 6/LCD_RGB_DB13: J701.29 (DB13), U704.35 (IO42)
/ESP32 6/LCD_RGB_DB14: J701.30 (DB14), U704.24 (IO47)
/ESP32 6/LCD_RGB_DB15: J701.31 (DB15), U704.25 (IO48)
/ESP32 6/LCD_RGB_DB16: J701.32 (DB16)
/ESP32 6/LCD_RGB_DB17: J701.33 (DB17)
/ESP32 6/LCD_RGB_DE: J701.13 (DE), U704.34 (IO41)
/ESP32 6/LCD_RGB_HSYNC: J701.15 (HS), U704.32 (IO39)
/ESP32 6/LCD_RGB_PCLK: J701.12 (PCLK), U704.31 (IO38)
/ESP32 6/LCD_RGB_VSYNC: J701.14 (VS), U704.33 (IO40)
/ESP32 6/PWR_IN: C703.1, U701.2 (VOUT), U701.7 (VOUT), U702.4 (EN), U702.6 (IN)
/ESP32 6/SPI_CS0: U703.1 (A), U704.18 (IO10)
/ESP32 6/SPI_CS1: U703.2 (B), U704.16 (IO46)
/ESP32 6/SPI_CS_FLASH: D704.2 (A), RN701.6, U703.6 (Y1), U707.1 (~CS)
/ESP32 6/SPI_CS_LCD: D705.2 (A), J701.11 (CS), RN701.5, U703.7 (Y0)
/ESP32 6/SPI_MISO: U704.26 (IO45), U705.3 (B1), U707.2 (DO/IO_{1})
/ESP32 6/SPI_MOSI: J701.9 (SDA), U704.12 (IO8), U705.5 (A2), U707.5 (DI/IO_{0})
/ESP32 6/SPI_SCK: J701.10 (SCK), U704.17 (IO9), U705.9 (A3), U707.6 (CLK)
/ESP32 6/SPI_µSD_BUS_CONNECT: D702.2 (A), RN701.8, U703.3 (Y3), U705.1 (1~OE), U705.4 (2~OE), U705.10 (3~OE), U705.13 (4~OE)
/ESP32 6/STRAP_GPIO3: U704.15 (IO3)
/ESP32 6/UART-RS485_RX: U704.20 (IO12), U708.1 (RO)
/ESP32 6/UART-RS485_TX: U704.19 (IO11), U708.4 (DI)
/ESP32 6/UART_RS485_DE: U704.23 (IO21), U708.2 (~RE), U708.3 (DE)
/ESP32 7/+3V3: C804.1, C805.1, C806.1, C807.1, C808.1, C809.1, C810.1, C811.1, C816.1, D801.2 (A), J801.5 (VDD), RN801.1 (4), RN801.2, RN801.3, RN801.4, U802.1 (OUT), U803.8 (VCC), U804.2 (3V3), U805.14 (VCC), U807.8 (VCC), U808.8 (VCC)
/ESP32 7/BATT_IN: C802.1, L801.1, U801.3 (VIN1), U806.1 (SW)
/ESP32 7/LCD_RGB_DB0: J801.16 (DB0), U804.38 (IO2)
/ESP32 7/LCD_RGB_DB1: J801.17 (DB1), U804.4 (IO4)
/ESP32 7/LCD_RGB_DB2: J801.18 (DB2), U804.5 (IO5)
/ESP32 7/LCD_RGB_DB3: J801.19 (DB3), U804.6 (IO6)
/ESP32 7/LCD_RGB_DB4: J801.20 (DB4), U804.7 (IO7)
/ESP32 7/LCD_RGB_DB5: J801.21 (DB5), U804.21 (IO13)
/ESP32 7/LCD_RGB_DB6: J801.22 (DB6), U804.22 (IO14)
/ESP32 7/LCD_RGB_DB7: J801.23 (DB7), U804.8 (IO15)
/ESP32 7/LCD_RGB_DB8: J801.24 (DB8), U804.9 (IO16)
/ESP32 7/LCD_RGB_DB9: J801.25 (DB9), U804.10 (IO17)
/ESP32 7/LCD_RGB_DB10: J801.26 (DB10), U804.11 (IO18)
/ESP32 7/LCD_RGB_DB11: J801.27 (DB11), U804.13 (USB_D-)
/ESP32 7/LCD_RGB_DB12: J801.28 (DB12), U804.14 (USB_D+)
/ESP32 7/LCD_RGB_DB13: J801.29 (DB13), U804.35 (IO42)
/ESP32 7/LCD_RGB_DB14: J801.30 (DB14), U804.24 (IO47)
/ESP32 7/LCD_RGB_DB15: J801.31 (DB15), U804.25 (IO48)
/ESP32 7/LCD_RGB_DB16: J801.32 (DB16)
/ESP32 7/LCD_RGB_DB17: J801.33 (DB17)
/ESP32 7/LCD_RGB_DE: J801.13 (DE), U804.34 (IO41)
/ESP32 7/LCD_RGB_HSYNC: J801.15 (HS), U804.32 (IO39)
/ESP32 7/LCD_RGB_PCLK: J801.12 (PCLK), U804.31 (IO38)
/ESP32 7/LCD_RGB_VSYNC: J801.14 (VS), U804.33 (IO40)
/ESP32 7/PWR_IN: C803.1, U801.2 (VOUT), U801.7 (VOUT), U802.4 (EN), U802.6 (IN)
/ESP32 7/SPI_CS0: U803.1 (A), U804.18 (IO10)
/ESP32 7/SPI_CS1: U803.2 (B), U804.16 (IO46)
/ESP32 7/SPI_CS_FLASH: D804.2 (A), RN801.6, U803.6 (Y1), U807.1 (~CS)
/ESP32 7/SPI_CS_LCD: D805.2 (A), J801.11 (CS), RN801.5, U803.7 (Y0)
/ESP32 7/SPI_MISO: U804.26 (IO45), U805.3 (B1), U807.2 (DO/IO_{1})
/ESP32 7/SPI_MOSI: J801.9 (SDA), U804.12 (IO8), U805.5 (A2), U807.5 (DI/IO_{0})
/ESP32 7/SPI_SCK: J801.10 (SCK), U804.17 (IO9), U805.9 (A3), U807.6 (CLK)
/ESP32 7/SPI_µSD_BUS_CONNECT: D802.2 (A), RN801.8, U803.3 (Y3), U805.1 (1~OE), U805.4 (2~OE), U805.10 (3~OE), U805.13 (4~OE)
/ESP32 7/STRAP_GPIO3: U804.15 (IO3)
/ESP32 7/UART-RS485_RX: U804.20 (IO12), U808.1 (RO)
/ESP32 7/UART-RS485_TX: U804.19 (IO11), U808.4 (DI)
/ESP32 7/UART_RS485_DE: U804.23 (IO21), U808.2 (~RE), U808.3 (DE)
/ESP32 8/+3V3: C904.1, C905.1, C906.1, C907.1, C908.1, C909.1, C910.1, C911.1, C916.1, D901.2 (A), J901.5 (VDD), RN901.1 (4), RN901.2, RN901.3, RN901.4, U902.1 (OUT), U903.8 (VCC), U904.2 (3V3), U905.14 (VCC), U907.8 (VCC), U908.8 (VCC)
/ESP32 8/BATT_IN: C902.1, L901.1, U901.3 (VIN1), U906.1 (SW)
/ESP32 8/LCD_RGB_DB0: J901.16 (DB0), U904.38 (IO2)
/ESP32 8/LCD_RGB_DB1: J901.17 (DB1), U904.4 (IO4)
/ESP32 8/LCD_RGB_DB2: J901.18 (DB2), U904.5 (IO5)
/ESP32 8/LCD_RGB_DB3: J901.19 (DB3), U904.6 (IO6)
/ESP32 8/LCD_RGB_DB4: J901.20 (DB4), U904.7 (IO7)
/ESP32 8/LCD_RGB_DB5: J901.21 (DB5), U904.21 (IO13)
/ESP32 8/LCD_RGB_DB6: J901.22 (DB6), U904.22 (IO14)
/ESP32 8/LCD_RGB_DB7: J901.23 (DB7), U904.8 (IO15)
/ESP32 8/LCD_RGB_DB8: J901.24 (DB8), U904.9 (IO16)
/ESP32 8/LCD_RGB_DB9: J901.25 (DB9), U904.10 (IO17)
/ESP32 8/LCD_RGB_DB10: J901.26 (DB10), U904.11 (IO18)
/ESP32 8/LCD_RGB_DB11: J901.27 (DB11), U904.13 (USB_D-)
/ESP32 8/LCD_RGB_DB12: J901.28 (DB12), U904.14 (USB_D+)
/ESP32 8/LCD_RGB_DB13: J901.29 (DB13), U904.35 (IO42)
/ESP32 8/LCD_RGB_DB14: J901.30 (DB14), U904.24 (IO47)
/ESP32 8/LCD_RGB_DB15: J901.31 (DB15), U904.25 (IO48)
/ESP32 8/LCD_RGB_DB16: J901.32 (DB16)
/ESP32 8/LCD_RGB_DB17: J901.33 (DB17)
/ESP32 8/LCD_RGB_DE: J901.13 (DE), U904.34 (IO41)
/ESP32 8/LCD_RGB_HSYNC: J901.15 (HS), U904.32 (IO39)
/ESP32 8/LCD_RGB_PCLK: J901.12 (PCLK), U904.31 (IO38)
/ESP32 8/LCD_RGB_VSYNC: J901.14 (VS), U904.33 (IO40)
/ESP32 8/PWR_IN: C903.1, U901.2 (VOUT), U901.7 (VOUT), U902.4 (EN), U902.6 (IN)
/ESP32 8/SPI_CS0: U903.1 (A), U904.18 (IO10)
/ESP32 8/SPI_CS1: U903.2 (B), U904.16 (IO46)
/ESP32 8/SPI_CS_FLASH: D904.2 (A), RN901.6, U903.6 (Y1), U907.1 (~CS)
/ESP32 8/SPI_CS_LCD: D905.2 (A), J901.11 (CS), RN901.5, U903.7 (Y0)
/ESP32 8/SPI_MISO: U904.26 (IO45), U905.3 (B1), U907.2 (DO/IO_{1})
/ESP32 8/SPI_MOSI: J901.9 (SDA), U904.12 (IO8), U905.5 (A2), U907.5 (DI/IO_{0})
/ESP32 8/SPI_SCK: J901.10 (SCK), U904.17 (IO9), U905.9 (A3), U907.6 (CLK)
/ESP32 8/SPI_µSD_BUS_CONNECT: D902.2 (A), RN901.8, U903.3 (Y3), U905.1 (1~OE), U905.4 (2~OE), U905.10 (3~OE), U905.13 (4~OE)
/ESP32 8/STRAP_GPIO3: U904.15 (IO3)
/ESP32 8/UART-RS485_RX: U904.20 (IO12), U908.1 (RO)
/ESP32 8/UART-RS485_TX: U904.19 (IO11), U908.4 (DI)
/ESP32 8/UART_RS485_DE: U904.23 (IO21), U908.2 (~RE), U908.3 (DE)
/ESP32 9/+3V3: C1004.1, C1005.1, C1006.1, C1007.1, C1008.1, C1009.1, C1010.1, C1011.1, C1016.1, D1001.2 (A), J1001.5 (VDD), RN1001.1 (4), RN1001.2, RN1001.3, RN1001.4, U1002.1 (OUT), U1003.8 (VCC), U1004.2 (3V3), U1005.14 (VCC), U1007.8 (VCC), U1008.8 (VCC)
/ESP32 9/BATT_IN: C1002.1, L1001.1, U1001.3 (VIN1), U1006.1 (SW)
/ESP32 9/LCD_RGB_DB0: J1001.16 (DB0), U1004.38 (IO2)
/ESP32 9/LCD_RGB_DB1: J1001.17 (DB1), U1004.4 (IO4)
/ESP32 9/LCD_RGB_DB2: J1001.18 (DB2), U1004.5 (IO5)
/ESP32 9/LCD_RGB_DB3: J1001.19 (DB3), U1004.6 (IO6)
/ESP32 9/LCD_RGB_DB4: J1001.20 (DB4), U1004.7 (IO7)
/ESP32 9/LCD_RGB_DB5: J1001.21 (DB5), U1004.21 (IO13)
/ESP32 9/LCD_RGB_DB6: J1001.22 (DB6), U1004.22 (IO14)
/ESP32 9/LCD_RGB_DB7: J1001.23 (DB7), U1004.8 (IO15)
/ESP32 9/LCD_RGB_DB8: J1001.24 (DB8), U1004.9 (IO16)
/ESP32 9/LCD_RGB_DB9: J1001.25 (DB9), U1004.10 (IO17)
/ESP32 9/LCD_RGB_DB10: J1001.26 (DB10), U1004.11 (IO18)
/ESP32 9/LCD_RGB_DB11: J1001.27 (DB11), U1004.13 (USB_D-)
/ESP32 9/LCD_RGB_DB12: J1001.28 (DB12), U1004.14 (USB_D+)
/ESP32 9/LCD_RGB_DB13: J1001.29 (DB13), U1004.35 (IO42)
/ESP32 9/LCD_RGB_DB14: J1001.30 (DB14), U1004.24 (IO47)
/ESP32 9/LCD_RGB_DB15: J1001.31 (DB15), U1004.25 (IO48)
/ESP32 9/LCD_RGB_DB16: J1001.32 (DB16)
/ESP32 9/LCD_RGB_DB17: J1001.33 (DB17)
/ESP32 9/LCD_RGB_DE: J1001.13 (DE), U1004.34 (IO41)
/ESP32 9/LCD_RGB_HSYNC: J1001.15 (HS), U1004.32 (IO39)
/ESP32 9/LCD_RGB_PCLK: J1001.12 (PCLK), U1004.31 (IO38)
/ESP32 9/LCD_RGB_VSYNC: J1001.14 (VS), U1004.33 (IO40)
/ESP32 9/PWR_IN: C1003.1, U1001.2 (VOUT), U1001.7 (VOUT), U1002.4 (EN), U1002.6 (IN)
/ESP32 9/SPI_CS0: U1003.1 (A), U1004.18 (IO10)
/ESP32 9/SPI_CS1: U1003.2 (B), U1004.16 (IO46)
/ESP32 9/SPI_CS_FLASH: D1004.2 (A), RN1001.6, U1003.6 (Y1), U1007.1 (~CS)
/ESP32 9/SPI_CS_LCD: D1005.2 (A), J1001.11 (CS), RN1001.5, U1003.7 (Y0)
/ESP32 9/SPI_MISO: U1004.26 (IO45), U1005.3 (B1), U1007.2 (DO/IO_{1})
/ESP32 9/SPI_MOSI: J1001.9 (SDA), U1004.12 (IO8), U1005.5 (A2), U1007.5 (DI/IO_{0})
/ESP32 9/SPI_SCK: J1001.10 (SCK), U1004.17 (IO9), U1005.9 (A3), U1007.6 (CLK)
/ESP32 9/SPI_µSD_BUS_CONNECT: D1002.2 (A), RN1001.8, U1003.3 (Y3), U1005.1 (1~OE), U1005.4 (2~OE), U1005.10 (3~OE), U1005.13 (4~OE)
/ESP32 9/STRAP_GPIO3: U1004.15 (IO3)
/ESP32 9/UART-RS485_RX: U1004.20 (IO12), U1008.1 (RO)
/ESP32 9/UART-RS485_TX: U1004.19 (IO11), U1008.4 (DI)
/ESP32 9/UART_RS485_DE: U1004.23 (IO21), U1008.2 (~RE), U1008.3 (DE)
/FRAME_SYNC: U304.39 (IO1), U308.7 (B), U404.39 (IO1), U408.7 (B), U504.39 (IO1), U508.7 (B), U604.39 (IO1), U608.7 (B), U704.39 (IO1), U708.7 (B), U804.39 (IO1), U808.7 (B), U904.39 (IO1), U908.7 (B), U1004.39 (IO1), U1008.7 (B); also elsewhere on the board
/PROG_ESP2_EN: U304.3 (EN); also elsewhere on the board
/PROG_ESP2_IO0: U304.27 (IO0); also elsewhere on the board
/PROG_ESP2_PWR: C301.1, U301.6 (VIN2); also elsewhere on the board
/PROG_ESP2_RXD0: U304.36 (RXD0); also elsewhere on the board
/PROG_ESP2_TXD0: U304.37 (TXD0); also elsewhere on the board
/PROG_ESP3_EN: U404.3 (EN); also elsewhere on the board
/PROG_ESP3_IO0: U404.27 (IO0); also elsewhere on the board
/PROG_ESP3_PWR: C401.1, U401.6 (VIN2); also elsewhere on the board
/PROG_ESP3_RXD0: U404.36 (RXD0); also elsewhere on the board
/PROG_ESP3_TXD0: U404.37 (TXD0); also elsewhere on the board
/PROG_ESP4_EN: U504.3 (EN); also elsewhere on the board
/PROG_ESP4_IO0: U504.27 (IO0); also elsewhere on the board
/PROG_ESP4_PWR: C501.1, U501.6 (VIN2); also elsewhere on the board
/PROG_ESP4_RXD0: U504.36 (RXD0); also elsewhere on the board
/PROG_ESP4_TXD0: U504.37 (TXD0); also elsewhere on the board
/PROG_ESP5_EN: U604.3 (EN); also elsewhere on the board
/PROG_ESP5_IO0: U604.27 (IO0); also elsewhere on the board
/PROG_ESP5_PWR: C601.1, U601.6 (VIN2); also elsewhere on the board
/PROG_ESP5_RXD0: U604.36 (RXD0); also elsewhere on the board
/PROG_ESP5_TXD0: U604.37 (TXD0); also elsewhere on the board
/PROG_ESP6_EN: U704.3 (EN); also elsewhere on the board
/PROG_ESP6_IO0: U704.27 (IO0); also elsewhere on the board
/PROG_ESP6_PWR: C701.1, U701.6 (VIN2); also elsewhere on the board
/PROG_ESP6_RXD0: U704.36 (RXD0); also elsewhere on the board
/PROG_ESP6_TXD0: U704.37 (TXD0); also elsewhere on the board
/PROG_ESP7_EN: U804.3 (EN); also elsewhere on the board
/PROG_ESP7_IO0: U804.27 (IO0); also elsewhere on the board
/PROG_ESP7_PWR: C801.1, U801.6 (VIN2); also elsewhere on the board
/PROG_ESP7_RXD0: U804.36 (RXD0); also elsewhere on the board
/PROG_ESP7_TXD0: U804.37 (TXD0); also elsewhere on the board
/PROG_ESP8_EN: U904.3 (EN); also elsewhere on the board
/PROG_ESP8_IO0: U904.27 (IO0); also elsewhere on the board
/PROG_ESP8_PWR: C901.1, U901.6 (VIN2); also elsewhere on the board
/PROG_ESP8_RXD0: U904.36 (RXD0); also elsewhere on the board
/PROG_ESP8_TXD0: U904.37 (TXD0); also elsewhere on the board
/PROG_ESP9_EN: U1004.3 (EN); also elsewhere on the board
/PROG_ESP9_IO0: U1004.27 (IO0); also elsewhere on the board
/PROG_ESP9_PWR: C1001.1, U1001.6 (VIN2); also elsewhere on the board
/PROG_ESP9_RXD0: U1004.36 (RXD0); also elsewhere on the board
/PROG_ESP9_TXD0: U1004.37 (TXD0); also elsewhere on the board
/RS485_A: U308.6 (A), U408.6 (A), U508.6 (A), U608.6 (A), U708.6 (A), U808.6 (A), U908.6 (A), U1008.6 (A); also elsewhere on the board
/SAMD21/BACKLIGHT_PWM: U306.4 (CTRL), U406.4 (CTRL), U506.4 (CTRL), U606.4 (CTRL), U706.4 (CTRL), U806.4 (CTRL), U906.4 (CTRL), U1006.4 (CTRL); also elsewhere on the board
/SAMD21/SPI_MISO_µSD: U305.2 (A1), U405.2 (A1), U505.2 (A1), U605.2 (A1), U705.2 (A1), U805.2 (A1), U905.2 (A1), U1005.2 (A1); also elsewhere on the board
/SAMD21/SPI_MOSI_µSD: U305.6 (B2), U405.6 (B2), U505.6 (B2), U605.6 (B2), U705.6 (B2), U805.6 (B2), U905.6 (B2), U1005.6 (B2); also elsewhere on the board
/SAMD21/SPI_SCK_µSD: U305.8 (B3), U405.8 (B3), U505.8 (B3), U605.8 (B3), U705.8 (B3), U805.8 (B3), U905.8 (B3), U1005.8 (B3); also elsewhere on the board
GND: C301.2, C302.2, C303.2, C304.2, C305.2, C306.2, C307.2, C308.2, C309.2, C310.2, C311.2, C312.2, C313.2, C314.2, C315.2, C316.2, C401.2, C402.2, C403.2, C404.2, C405.2, C406.2, C407.2, C408.2, C409.2, C410.2, C411.2, C412.2, C413.2, C414.2, C415.2, C416.2, C501.2, C502.2, C503.2, C504.2, C505.2, C506.2, C507.2, C508.2, C509.2, C510.2, C511.2, C512.2, C513.2, C514.2, C515.2, C516.2, C601.2, C602.2, C603.2, C604.2, C605.2, C606.2, C607.2, C608.2, C609.2, C610.2, C611.2, C612.2, C613.2, C614.2, C615.2, C616.2, C701.2, C702.2, C703.2, C704.2, C705.2, C706.2, C707.2, C708.2, C709.2, C710.2, C711.2, C712.2, C713.2, C714.2, C715.2, C716.2, C801.2, C802.2, C803.2, C804.2, C805.2, C806.2, C807.2, C808.2, C809.2, C810.2, C811.2, C812.2, C813.2, C814.2, C815.2, C816.2, C901.2, C902.2, C903.2, C904.2, C905.2, C906.2, C907.2, C908.2, C909.2, C910.2, C911.2, C912.2, C913.2, C914.2, C915.2, C916.2, C1001.2, C1002.2, C1003.2, C1004.2, C1005.2, C1006.2, C1007.2, C1008.2, C1009.2, C1010.2, C1011.2, C1012.2, C1013.2, C1014.2, C1015.2, C1016.2, J301.4 (GND), J301.34 (GND), J301.40 (GND), J301.S1 (M), J301.S2 (M), J401.4 (GND), J401.34 (GND), J401.40 (GND), J401.S1 (M), J401.S2 (M), J501.4 (GND), J501.34 (GND), J501.40 (GND), J501.S1 (M), J501.S2 (M), J601.4 (GND), J601.34 (GND), J601.40 (GND), J601.S1 (M), J601.S2 (M), J701.4 (GND), J701.34 (GND), J701.40 (GND), J701.S1 (M), J701.S2 (M), J801.4 (GND), J801.34 (GND), J801.40 (GND), J801.S1 (M), J801.S2 (M), J901.4 (GND), J901.34 (GND), J901.40 (GND), J901.S1 (M), J901.S2 (M), J1001.4 (GND), J1001.34 (GND), J1001.40 (GND), J1001.S1 (M), J1001.S2 (M), R301.2, R302.2, R401.2, R402.2, R501.2, R502.2, R601.2, R602.2, R701.2, R702.2, R801.2, R802.2, R901.2, R902.2, R1001.2, R1002.2, RN302.5, RN302.6, RN302.7 (5), RN302.8, RN402.5, RN402.6, RN402.7 (5), RN402.8, RN502.5, RN502.6, RN502.7 (5), RN502.8, RN602.5, RN602.6, RN602.7 (5), RN602.8, RN702.5, RN702.6, RN702.7 (5), RN702.8, RN802.5, RN802.6, RN802.7 (5), RN802.8, RN902.5, RN902.6, RN902.7 (5), RN902.8, RN1002.5, RN1002.6, RN1002.7 (5), RN1002.8, U301.1 (GND), U301.4 (~ON), U301.5 (GND), U302.3 (GND), U302.7 (GND), U303.4 (GND), U304.1 (GND), U304.40 (GND), U304.41 (GND), U305.7 (GND), U306.2 (GND), U308.5 (GND), U401.1 (GND), U401.4 (~ON), U401.5 (GND), U402.3 (GND), U402.7 (GND), U403.4 (GND), U404.1 (GND), U404.40 (GND), U404.41 (GND), U405.7 (GND), U406.2 (GND), U408.5 (GND), U501.1 (GND), U501.4 (~ON), U501.5 (GND), U502.3 (GND), U502.7 (GND), U503.4 (GND), U504.1 (GND), U504.40 (GND), U504.41 (GND), U505.7 (GND), U506.2 (GND), U508.5 (GND), U601.1 (GND), U601.4 (~ON), U601.5 (GND), U602.3 (GND), U602.7 (GND), U603.4 (GND), U604.1 (GND), U604.40 (GND), U604.41 (GND), U605.7 (GND), U606.2 (GND), U608.5 (GND), U701.1 (GND), U701.4 (~ON), U701.5 (GND), U702.3 (GND), U702.7 (GND), U703.4 (GND), U704.1 (GND), U704.40 (GND), U704.41 (GND), U705.7 (GND), U706.2 (GND), U708.5 (GND), U801.1 (GND), U801.4 (~ON), U801.5 (GND), U802.3 (GND), U802.7 (GND), U803.4 (GND), U804.1 (GND), U804.40 (GND), U804.41 (GND), U805.7 (GND), U806.2 (GND), U808.5 (GND), U901.1 (GND), U901.4 (~ON), U901.5 (GND), U902.3 (GND), U902.7 (GND), U903.4 (GND), U904.1 (GND), U904.40 (GND), U904.41 (GND), U905.7 (GND), U906.2 (GND), U908.5 (GND), U1001.1 (GND), U1001.4 (~ON), U1001.5 (GND), U1002.3 (GND), U1002.7 (GND), U1003.4 (GND), U1004.1 (GND), U1004.40 (GND), U1004.41 (GND), U1005.7 (GND), U1006.2 (GND), U1008.5 (GND); also elsewhere on the board
unnamed: D301.1 (K), R301.1
unnamed: D302.1 (K), RN302.1 (4)
unnamed: D303.1 (K), RN302.2
unnamed: D304.1 (K), RN302.3
unnamed: D305.1 (K), RN302.4
unnamed: D401.1 (K), R401.1
unnamed: D402.1 (K), RN402.1 (4)
unnamed: D403.1 (K), RN402.2
unnamed: D404.1 (K), RN402.3
unnamed: D405.1 (K), RN402.4
unnamed: D501.1 (K), R501.1
unnamed: D502.1 (K), RN502.1 (4)
unnamed: D503.1 (K), RN502.2
unnamed: D504.1 (K), RN502.3
unnamed: D505.1 (K), RN502.4
unnamed: D601.1 (K), R601.1
unnamed: D602.1 (K), RN602.1 (4)
unnamed: D603.1 (K), RN602.2
unnamed: D604.1 (K), RN602.3
unnamed: D605.1 (K), RN602.4
unnamed: D701.1 (K), R701.1
unnamed: D702.1 (K), RN702.1 (4)
unnamed: D703.1 (K), RN702.2
unnamed: D704.1 (K), RN702.3
unnamed: D705.1 (K), RN702.4
unnamed: D801.1 (K), R801.1
unnamed: D802.1 (K), RN802.1 (4)
unnamed: D803.1 (K), RN802.2
unnamed: D804.1 (K), RN802.3
unnamed: D805.1 (K), RN802.4
unnamed: D901.1 (K), R901.1
unnamed: D902.1 (K), RN902.1 (4)
unnamed: D903.1 (K), RN902.2
unnamed: D904.1 (K), RN902.3
unnamed: D905.1 (K), RN902.4
unnamed: D1001.1 (K), R1001.1
unnamed: D1002.1 (K), RN1002.1 (4)
unnamed: D1003.1 (K), RN1002.2
unnamed: D1004.1 (K), RN1002.3
unnamed: D1005.1 (K), RN1002.4
unnamed: C313.1, C315.1, J301.1 (LEDA), U306.5 (V_{OUT})
unnamed: C413.1, C415.1, J401.1 (LEDA), U406.5 (V_{OUT})
unnamed: C513.1, C515.1, J501.1 (LEDA), U506.5 (V_{OUT})
unnamed: C613.1, C615.1, J601.1 (LEDA), U606.5 (V_{OUT})
unnamed: C713.1, C715.1, J701.1 (LEDA), U706.5 (V_{OUT})
unnamed: C813.1, C815.1, J801.1 (LEDA), U806.5 (V_{OUT})
unnamed: C913.1, C915.1, J901.1 (LEDA), U906.5 (V_{OUT})
unnamed: C1013.1, C1015.1, J1001.1 (LEDA), U1006.5 (V_{OUT})
unnamed: J301.2 (LEDK), J301.3 (LEDK), R302.1, U306.3 (FB)
unnamed: C312.1, C314.1, L301.2, U306.6 (V_{IN})
unnamed: J401.2 (LEDK), J401.3 (LEDK), R402.1, U406.3 (FB)
unnamed: C412.1, C414.1, L401.2, U406.6 (V_{IN})
unnamed: J501.2 (LEDK), J501.3 (LEDK), R502.1, U506.3 (FB)
unnamed: C512.1, C514.1, L501.2, U506.6 (V_{IN})
unnamed: J601.2 (LEDK), J601.3 (LEDK), R602.1, U606.3 (FB)
unnamed: C612.1, C614.1, L601.2, U606.6 (V_{IN})
unnamed: J701.2 (LEDK), J701.3 (LEDK), R702.1, U706.3 (FB)
unnamed: C712.1, C714.1, L701.2, U706.6 (V_{IN})
unnamed: J801.2 (LEDK), J801.3 (LEDK), R802.1, U806.3 (FB)
unnamed: C812.1, C814.1, L801.2, U806.6 (V_{IN})
unnamed: J901.2 (LEDK), J901.3 (LEDK), R902.1, U906.3 (FB)
unnamed: C912.1, C914.1, L901.2, U906.6 (V_{IN})
unnamed: J1001.2 (LEDK), J1001.3 (LEDK), R1002.1, U1006.3 (FB)
unnamed: C1012.1, C1014.1, L1001.2, U1006.6 (V_{IN})

Notes on the sheet:
Italics denote bootstrapping pins which go to weird states upon ESP32 reset. Be aware that these might be weird to get configured in software.
