twfth9/Morg_Grad_Cap/Grad/Hardware/Overview Design/grad_cap_display.kicad_pcb

## KiCad design Grad/Hardware/Overview Design/grad_cap_display.kicad_pcb (continued)

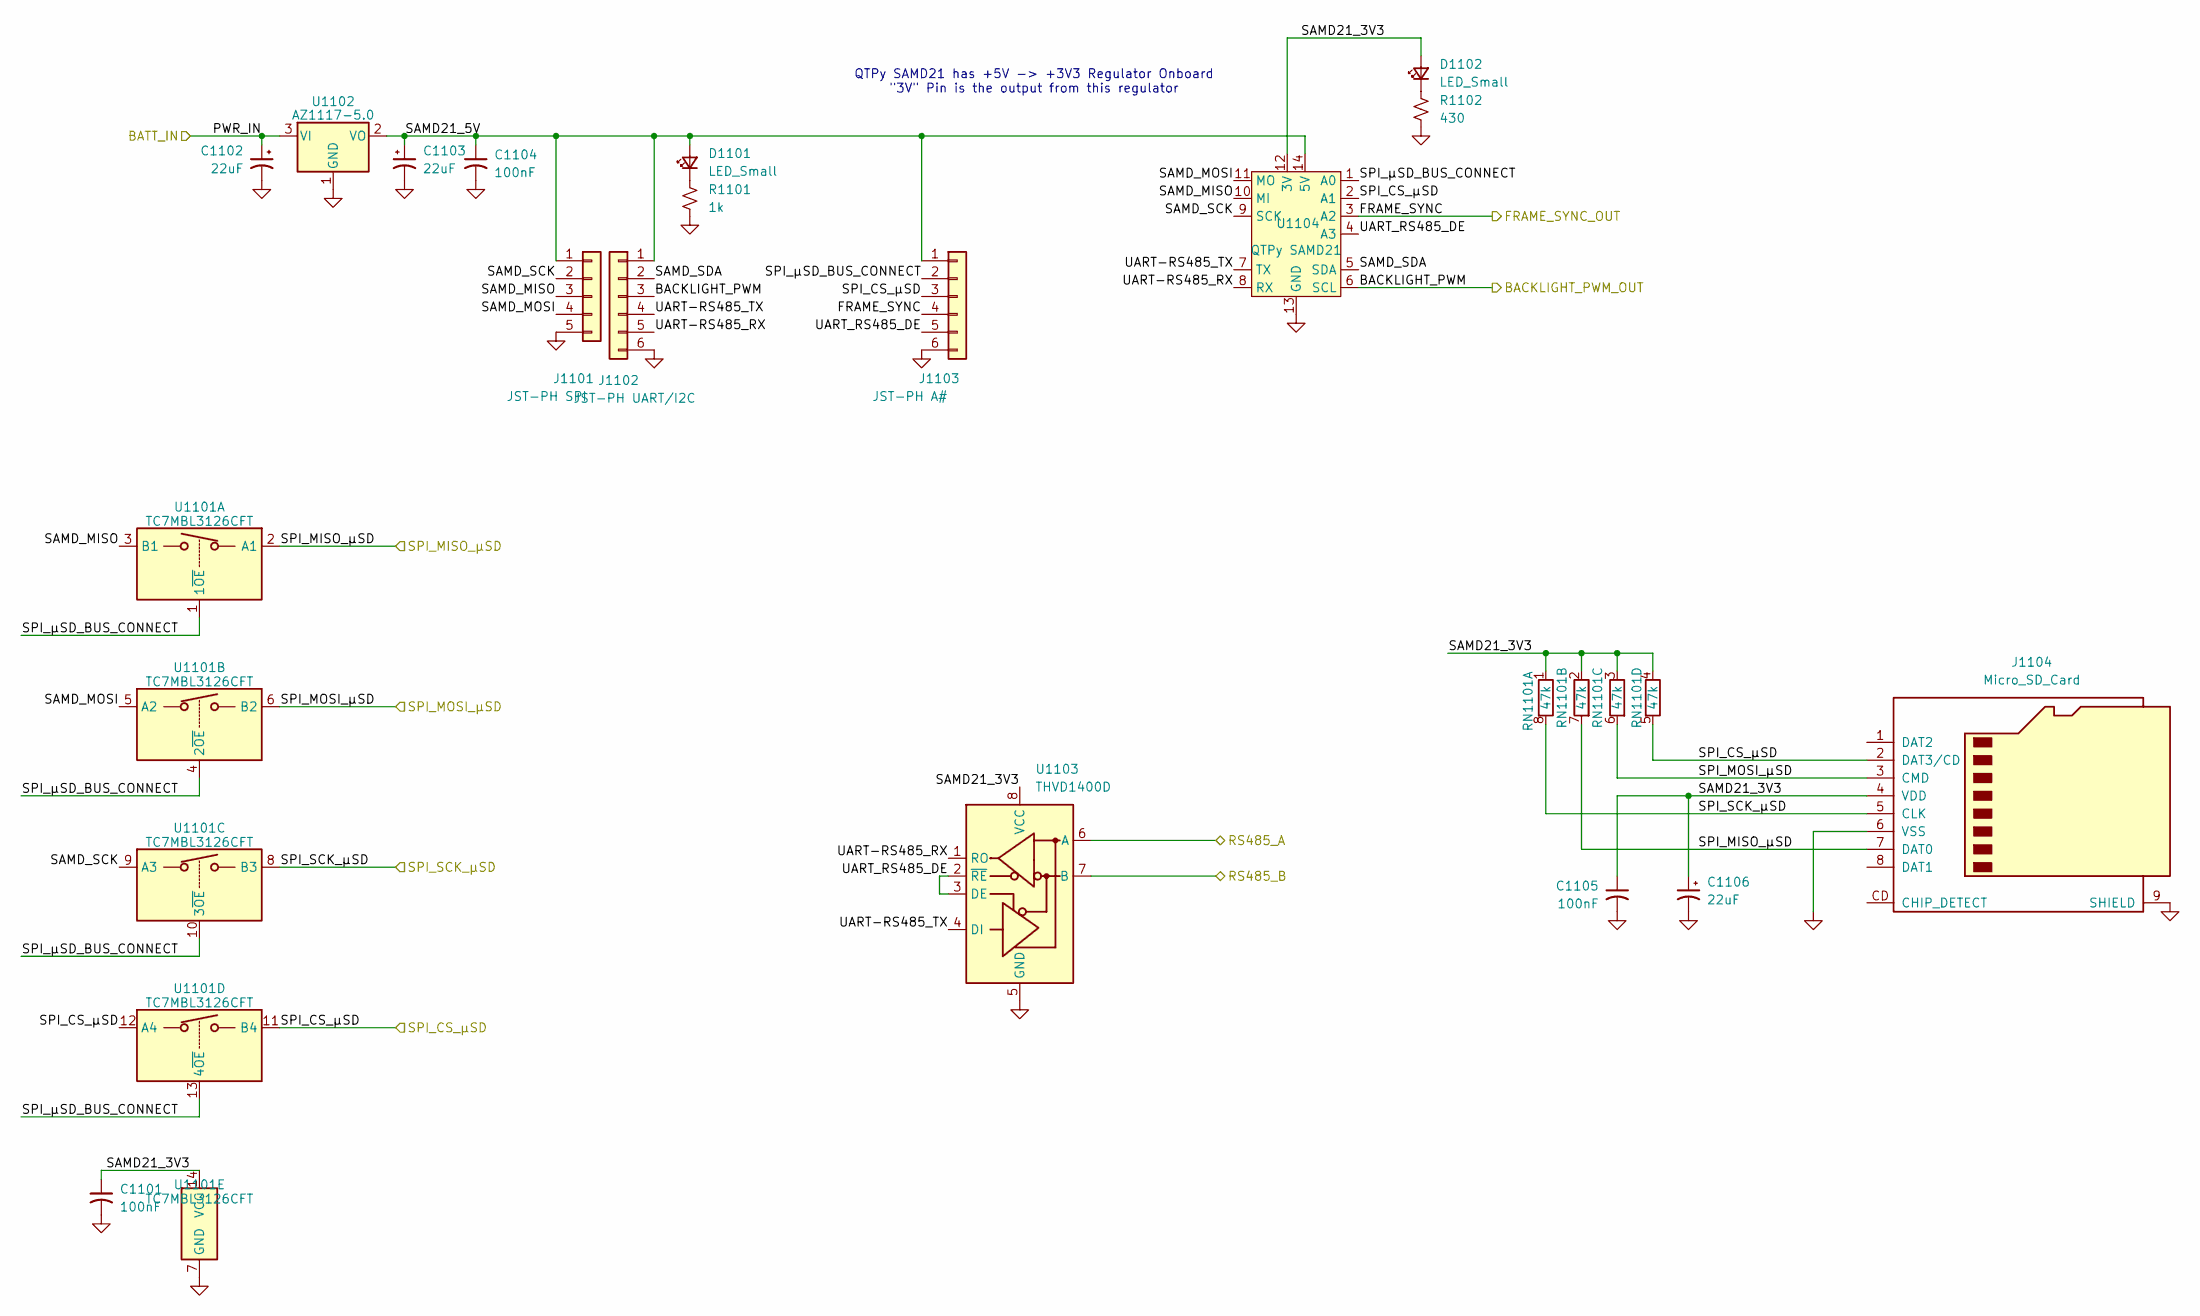
[picture p11: schematic SAMD21.kicad_sch]

Parts:
C1101, C1104, C1105: 100nF; C_0402_1005Metric
C1102, C1103, C1106: 22uF; C_0603_1608Metric
D1101, D1102: LED_Small; Worthington_LED_0603
J1101: JST-PH SPI; JST_PH_S5B-PH-K_1x05_P2.00mm_Horizontal
J1102: JST-PH UART/I2C; JST_PH_S6B-PH-K_1x06_P2.00mm_Horizontal
J1103: JST-PH A#; JST_PH_S6B-PH-K_1x06_P2.00mm_Horizontal
J1104: Micro_SD_Card; CUI_MSD-4-A; DigiKey Part 2223-MSD-4-ACT-ND
R1101: 1k; Worthington_R_0402
R1102: 430; Worthington_R_0402
RN1101: 47k; RESCAXE80P320X160X70-8N; DigiKey Part CAT16-4702F4LFCT-ND
U1101: TC7MBL3126CFT; TSSOP-14_4.4x5mm_P0.65mm
U1102: AZ1117-5.0; SOT-223-3_TabPin2
U1103: THVD1400D; SOIC-8_3.9x4.9mm_P1.27mm
U1104: QTPy SAMD21; Py_QT_SAMD21

Connections:
/ESP32 1/SPI_CS_µSD: J1103.3, J1104.2 (DAT3/CD), RN1101.5, U1101.11 (B4), U1101.12 (A4), U1104.2 (A1); also elsewhere on the board
/FRAME_SYNC: J1103.4, U1103.7 (B), U1104.3 (A2); also elsewhere on the board
/RS485_A: U1103.6 (A); also elsewhere on the board
/SAMD21/BACKLIGHT_PWM: J1102.3, U1104.6 (SCL); also elsewhere on the board
/SAMD21/PWR_IN: C1102.1, U1102.3 (VI)
/SAMD21/SAMD21_3V3: C1101.1, C1105.1, C1106.1, D1102.2 (A), J1104.4 (VDD), RN1101.1 (4), RN1101.2, RN1101.3, RN1101.4, U1101.14 (VCC), U1103.8 (VCC), U1104.12 (3V)
/SAMD21/SAMD21_5V: C1103.1, C1104.1, D1101.2 (A), J1101.1, J1102.1, J1103.1, U1102.2 (VO), U1104.14 (5V)
/SAMD21/SAMD_MISO: J1101.3, U1101.3 (B1), U1104.10 (MI)
/SAMD21/SAMD_MOSI: J1101.4, U1101.5 (A2), U1104.11 (MO)
/SAMD21/SAMD_SCK: J1101.2, U1101.9 (A3), U1104.9 (SCK)
/SAMD21/SAMD_SDA: J1102.2, U1104.5 (SDA)
/SAMD21/SPI_MISO_µSD: J1104.7 (DAT0), RN1101.7 (5), U1101.2 (A1); also elsewhere on the board
/SAMD21/SPI_MOSI_µSD: J1104.3 (CMD), RN1101.6, U1101.6 (B2); also elsewhere on the board
/SAMD21/SPI_SCK_µSD: J1104.5 (CLK), RN1101.8, U1101.8 (B3); also elsewhere on the board
/SAMD21/SPI_µSD_BUS_CONNECT: J1103.2, U1101.1 (1~OE), U1101.4 (2~OE), U1101.10 (3~OE), U1101.13 (4~OE), U1104.1 (A0)
/SAMD21/UART-RS485_RX: J1102.5, U1103.1 (RO), U1104.8 (RX)
/SAMD21/UART-RS485_TX: J1102.4, U1103.4 (DI), U1104.7 (TX)
/SAMD21/UART_RS485_DE: J1103.5, U1103.2 (~RE), U1103.3 (DE), U1104.4 (A3)
GND: C1101.2, C1102.2, C1103.2, C1104.2, C1105.2, C1106.2, J1101.5, J1102.6, J1103.6, J1104.6 (VSS), J1104.9 (SHIELD), R1101.2, R1102.2, U1101.7 (GND), U1102.1 (GND), U1103.5 (GND), U1104.13 (GND); also elsewhere on the board
unnamed: D1101.1 (K), R1101.1
unnamed: D1102.1 (K), R1102.1

Notes on the sheet:
QTPy SAMD21 has +5V -> +3V3 Regulator Onboard "3V" Pin is the output from this regulator

Board: 2 copper layers, 345 parts (0 on the bottom side), 444 nets, no tracks yet.
