twfth9/Morg_Grad_Cap/Grad/Software/Test Scripts/GradCapCommon/examples/LCD Image Tests/ESP32_LCDImageTest3/pillars_jpg.h

#pragma once
#include <Arduino.h>

// 480x480 JPEG derived from the user-provided image.
const uint8_t pillars_jpg[] PROGMEM = {
  0xFF, 0xD8, 0xFF, 0xE0, 0x00, 0x10, 0x4A, 0x46, 0x49, 0x46, 0x00, 0x01,
  0x01, 0x00, 0x00, 0x01, 0x00, 0x01, 0x00, 0x00, 0xFF, 0xDB, 0x00, 0x43,
  0x00, 0x05, 0x03, 0x04, 0x04, 0x04, 0x03, 0x05, 0x04, 0x04, 0x04, 0x05,
  0x05, 0x05, 0x06, 0x07, 0x0C, 0x08, 0x07, 0x07, 0x07, 0x07, 0x0F, 0x0B,
  0x0B, 0x09, 0x0C, 0x11, 0x0F, 0x12, 0x12, 0x11, 0x0F, 0x11, 0x11, 0x13,
  0x16, 0x1C, 0x17, 0x13, 0x14, 0x1A, 0x15, 0x11, 0x11, 0x18, 0x21, 0x18,
  0x1A, 0x1D, 0x1D, 0x1F, 0x1F, 0x1F, 0x13, 0x17, 0x22, 0x24, 0x22, 0x1E,
  0x24, 0x1C, 0x1E, 0x1F, 0x1E, 0xFF, 0xDB, 0x00, 0x43, 0x01, 0x05, 0x05,
  0x05, 0x07, 0x06, 0x07, 0x0E, 0x08, 0x08, 0x0E, 0x1E, 0x14, 0x11, 0x14,
  0x1E, 0x1E, 0x1E, 0x1E, 0x1E, 0x1E, 0x1E, 0x1E, 0x1E, 0x1E, 0x1E, 0x1E,
  0x1E, 0x1E, 0x1E, 0x1E, 0x1E, 0x1E, 0x1E, 0x1E, 0x1E, 0x1E, 0x1E, 0x1E,
  0x1E, 0x1E, 0x1E, 0x1E, 0x1E, 0x1E, 0x1E, 0x1E, 0x1E, 0x1E, 0x1E, 0x1E,
  0x1E, 0x1E, 0x1E, 0x1E, 0x1E, 0x1E, 0x1E, 0x1E, 0x1E, 0x1E, 0x1E, 0x1E,
  0x1E, 0x1E, 0xFF, 0xC0, 0x00, 0x11, 0x08, 0x01, 0xE0, 0x01, 0xE0, 0x03,
  0x01, 0x22, 0x00, 0x02, 0x11, 0x01, 0x03, 0x11, 0x01, 0xFF, 0xC4, 0x00,
  0x1C, 0x00, 0x00, 0x02, 0x03, 0x01, 0x01, 0x01, 0x01, 0x00, 0x00, 0x00,
  0x00, 0x00, 0x00, 0x00, 0x00, 0x00, 0x04, 0x05, 0x02, 0x03, 0x06, 0x01,
  0x07, 0x00, 0x08, 0xFF, 0xC4, 0x00, 0x40, 0x10, 0x00, 0x02, 0x01, 0x02,
  0x05, 0x02, 0x04, 0x04, 0x04, 0x05, 0x04, 0x03, 0x00, 0x02, 0x00, 0x07,
  0x01, 0x02, 0x03, 0x04, 0x11, 0x00, 0x05, 0x12, 0x21, 0x31, 0x13, 0x41,
  0x06, 0x22, 0x51, 0x61, 0x14, 0x71, 0x81, 0x91, 0x23, 0x32, 0xA1, 0xB1,
  0x07, 0x42, 0xC1, 0xD1, 0xF0, 0x15, 0x52, 0xE1, 0xF1, 0x24, 0x33, 0x62,
  0x16, 0x82, 0x08, 0x72, 0x34, 0x92, 0x43, 0xA2, 0xE2, 0xFF, 0xC4, 0x00,
  0x1B, 0x01, 0x00, 0x02, 0x03, 0x01, 0x01, 0x01, 0x00, 0x00, 0x00, 0x00,
  0x00, 0x00, 0x00, 0x00, 0x00, 0x00, 0x02, 0x03, 0x01, 0x04, 0x05, 0x06,
  0x00, 0x07, 0xFF, 0xC4, 0x00, 0x33, 0x11, 0x00, 0x02, 0x02, 0x01, 0x04,
  0x01, 0x04, 0x01, 0x02, 0x05, 0x03, 0x05, 0x01, 0x01, 0x00, 0x00, 0x01,
  0x02, 0x00, 0x03, 0x11, 0x04, 0x12, 0x21, 0x31, 0x41, 0x05, 0x13, 0x22,
  0x51, 0x61, 0x14, 0x71, 0x06, 0x32, 0x81, 0x91, 0xC1, 0x23, 0xA1, 0xB1,
  0x15, 0x42, 0xD1, 0xF0, 0xF1, 0x24, 0xE1, 0xFF, 0xDA, 0x00, 0x0C, 0x03,
  0x01, 0x00, 0x02, 0x11, 0x03, 0x11, 0x00, 0x3F, 0x00, 0xFC, 0xED, 0x0B,
  0x05, 0x21, 0x9F, 0x4B, 0xEC, 0x2C, 0xB6, 0xE7, 0xE7, 0x6C, 0x13, 0x50,
  0xC0, 0x90, 0x8A, 0xE8, 0xC0, 0x8D, 0x60, 0x22, 0x69, 0x0A, 0xC7, 0x72,
  0x07, 0xF9, 0xDB, 0x6C, 0x11, 0x97, 0xD3, 0x54, 0x66, 0xA8, 0x94, 0x94,
  0x90, 0xB3, 0xFC, 0x34, 0x2F, 0x51, 0x36, 0x90, 0xAB, 0x75, 0x02, 0xEC,
  0xDB, 0xF2, 0x40, 0xDB, 0xE8, 0x2D, 0x81, 0x6A, 0x13, 0xA3, 0x2B, 0xAC,
  0x91, 0xB4, 0x4E, 0x18, 0x10, 0x25, 0xB8, 0x6D, 0x3E, 0x84, 0x7A, 0xF7,
  0xC6, 0xCA, 0x32, 0x93, 0x2B, 0x10, 0x40, 0x96, 0xCB, 0x0B, 0xB8, 0x57,
  0x45, 0x8A, 0xCE, 0x05, 0x82, 0x72, 0x00, 0x1C, 0x91, 0xDB, 0x83, 0x88,
  0xC2, 0xE6, 0x39, 0x03, 0x42, 0xE6, 0x17, 0x65, 0x65, 0x66, 0xD5, 0xB1,
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
};

const uint32_t pillars_jpg_len = 82605;
