twfth9/Morg_Grad_Cap/(commit log)

2024-10-14 Generated a few had designs
    [morg_grad_cap.kicad_sch]
2024-10-14 Finished PCB layout
    [4600 QTPy.step, morg_grad_cap.kicad_sch]
2024-10-14 Fixed silkscreen text
    [morg_grad_cap.kicad_pcb]
2024-10-15 Generated Gerber files, ordered
    [morg_grad_cap-B_Cu.gbl, morg_grad_cap-B_Mask.gbs, morg_grad_cap-B_Paste.gbp, morg_grad_cap-B_Silkscreen.gbo, morg_grad_cap-Edge_Cuts.gm1, morg_grad_cap-F_Cu.gtl, morg_grad_cap-F_Mask.gts, morg_grad_cap-F_Paste.gtp]
2024-12-13 Programmed hat modes
    Mode 1) Starry Night (~100 mA)
    Mode 2) Party Mode 1 (~1280 mA)
    Mode 3) KI5SXY Callsign (~200-400 mA)
    Mode 4) Party Mode 2 (~500-800 mA)
2025-07-29 Added image of schematic
    [morg_grad_cap.kicad_sch]
2026-02-13 Beginnings of cap V2
    [4600 QTPy.step, ESP32_MASTER.kicad_sch, ESP32_SLAVE.kicad_sch, grad_cap_display.kicad_pcb, grad_cap_display.kicad_sch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]
2026-02-15 Schematic feels done now
    [ESP32_MASTER.kicad_sch, SAMD21.kicad_sch, grad_cap_display.kicad_pcb, grad_cap_display.kicad_sch]
2026-02-15 Fix to SD Card Symbol
    [ESP32_MASTER.kicad_sch, SAMD21.kicad_sch, grad_cap_display.kicad_pcb]
2026-02-15 Start of modular PCB
    [4600 QTPy.step, ESP32_MASTER.kicad_sch, ESP32_SLAVE.kicad_sch, SAMD21.kicad_sch, grad_cap_display.kicad_pcb, grad_cap_display.kicad_sch]
2026-02-15 Prototype of PCB layout
    [ESP32_MASTER.kicad_sch, SAMD21.kicad_sch, grad_cap_display.kicad_pcb, grad_cap_display.kicad_sch]
2026-02-15 Fixed flipped FPC connector pinout
    [ESP32_MASTER.kicad_sch, grad_cap_display.kicad_pcb]
2026-02-15 Added components, more layout testing
    [grad_cap_display-B_Cu.gbr, grad_cap_display-B_Mask.gbr, grad_cap_display-B_Paste.gbr, grad_cap_display-B_Silkscreen.gbr, grad_cap_display-Edge_Cuts.gbr, grad_cap_display-F_Cu.gbr, grad_cap_display-F_Mask.gbr, grad_cap_display-F_Paste.gbr]
2026-02-16 More routing progress
    [ESP32_MASTER.kicad_sch, grad_cap_display.kicad_pcb, grad_cap_display.kicad_sch]
2026-02-16 Small tweaks
    [grad_cap_display.kicad_pcb, grad_cap_display.kicad_sch]
2026-02-20 Rev A gerbers generated, sent to fab
    [grad_cap_display-B_Cu.gbl, grad_cap_display-B_Cu.gbr, grad_cap_display-B_Mask.gbr, grad_cap_display-B_Mask.gbs, grad_cap_display-B_Paste.gbp, grad_cap_display-B_Paste.gbr, grad_cap_display-B_Silkscreen.gbo, grad_cap_display-B_Silkscreen.gbr]
2026-02-28 Reorganized repo by project
    [4600 QTPy.step, ESP32_MASTER.kicad_sch, ESP32_SLAVE.kicad_sch, SAMD21.kicad_sch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]
2026-03-18 Software test scripts created for PCB checkout
2026-03-23 Corrected bus disconnect switch datasheet link
    [grad_cap_display.kicad_sch]
2026-03-23 Created RS485 bus abstraction layer
    This helps get around the limitations of the bus being half-duplex.
    This also allows the SAMD21 to communicate with each ESP32 separately, while also addressing each ESP as they have traffic to send
    This is grow into how we control access to the micro SD card among every ESP
2026-04-13 LCDImageTest3 displays an image
    Had to make some hardware tweaks to pull this off. GPIO43 and GPIO44 needed to be jumpered to DB16 and DB17, and GPIO3 needed to be jumpered to RST on the LCD.
    GPIO 3 was left open because it was a strapping pin, but it turns out that doesn't matter here since the LCD gets reset after boot through this pin anyway.
    GPIO43/44 are used for the UART0 bootloading, but again this only is a problem during program loading and not during runtime. Jumpering these to DB16 add DB17 takes a steady hand...
    My original intention was to run the LCD display in RGB565 16-bit color mode since the ST7701 can operate in this mode. According to Table 12 of the ST7701 datasheet,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
    [Debug485.cpp, Debug485.h, ESP32_LCDImageTest3.ino, HatLCD.cpp, HatLCD.h, HatPins.h, HatSpiMux.c, HatSpiMux.h]
